Vinayrnani/vseedtaper/print/chassis.stl

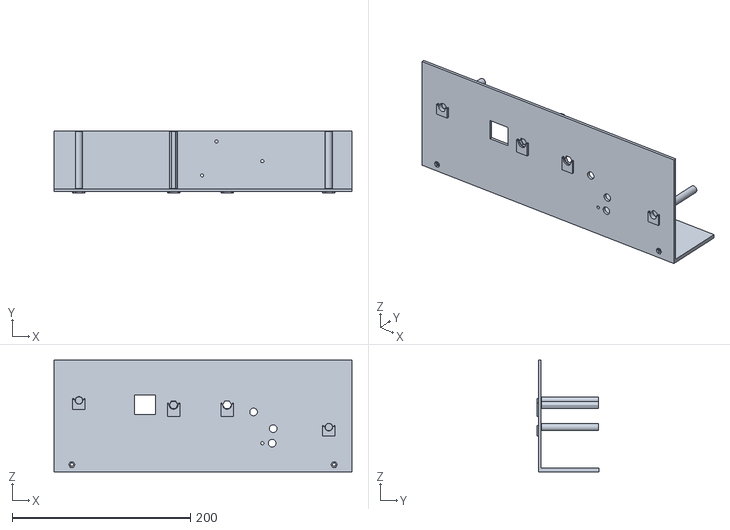
[picture p1: CAD file, 2026-09-26]
print/chassis.stl
334.0 x 70.0 x 125.0
