Vinayrnani/vseedtaper/print/plow.stl

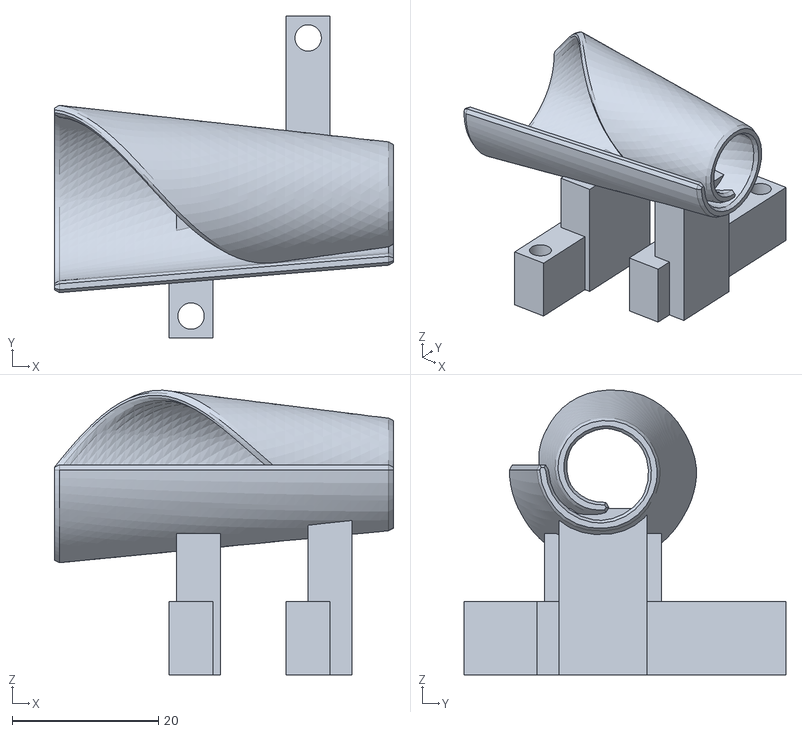
[picture p2: CAD file, 2026-09-26]
print/plow.stl
46.4 x 44.0 x 38.9
