Vinayrnani/vseedtaper/print/gear_A.stl

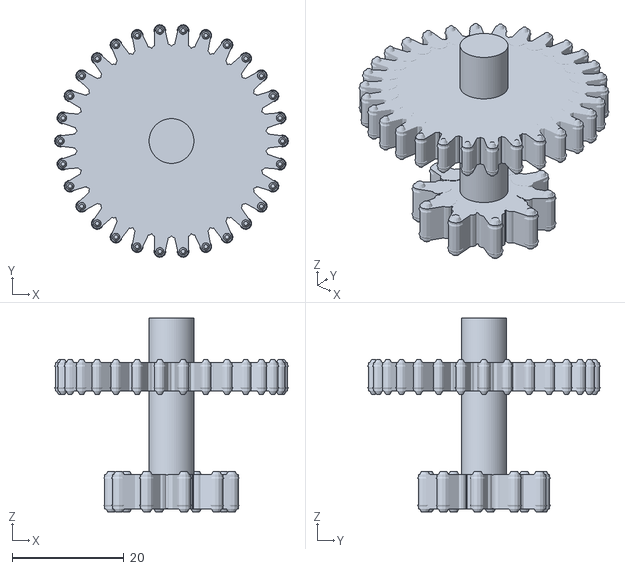
[picture p3: CAD file, 2026-09-26]
print/gear_A.stl
41.8 x 41.6 x 34.6
