Vinayrnani/vseedtaper/print/gear_I.stl

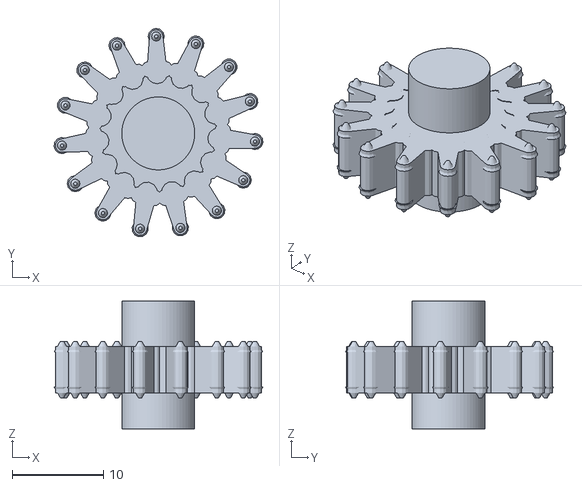
[picture p4: CAD file, 2026-09-26]
print/gear_I.stl
22.9 x 22.8 x 14.0
