Vinayrnani/vseedtaper/print/twister.stl

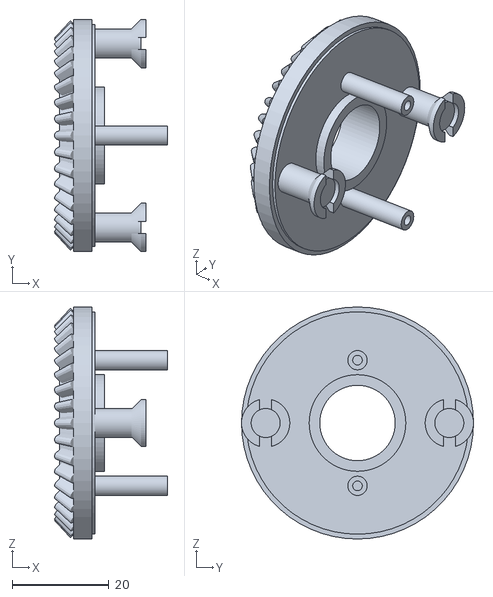
[picture p5: CAD file, 2026-09-26]
print/twister.stl
23.4 x 48.0 x 48.0
