Vinayrnani/vseedtaper/print/gear_B.stl

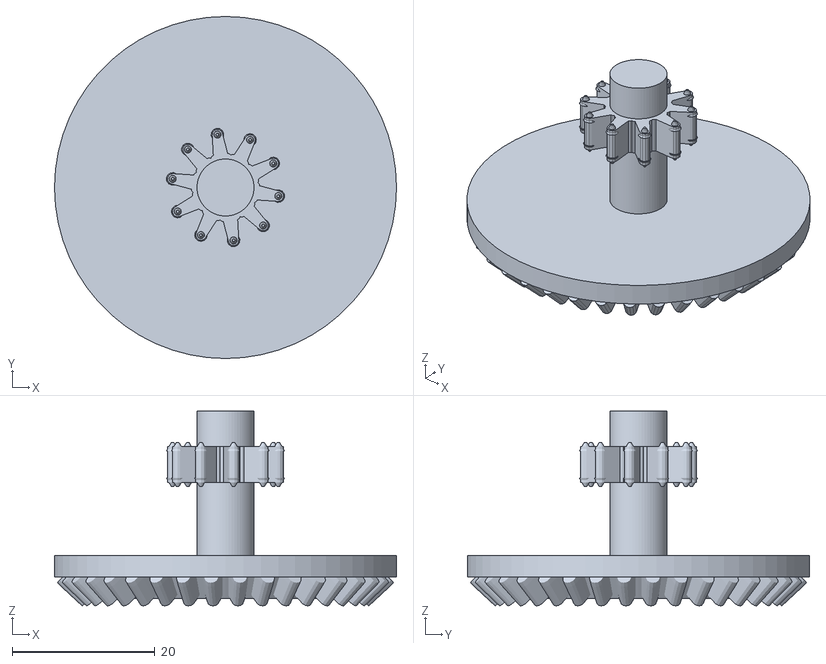
[picture p6: CAD file, 2026-09-26]
print/gear_B.stl
48.0 x 48.0 x 27.3
