Vinayrnani/vseedtaper/print/gearwall.stl

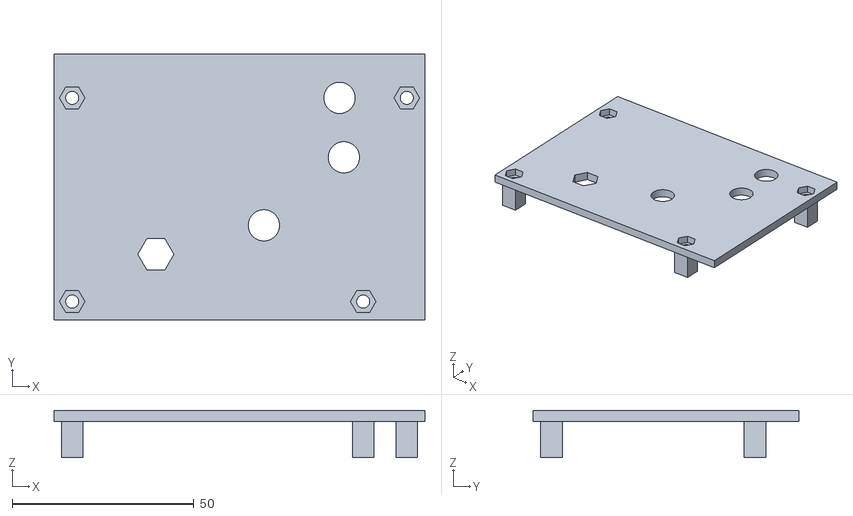
[picture p7: CAD file, 2026-09-26]
print/gearwall.stl
102.0 x 73.0 x 13.0
