Vinayrnani/vseedtaper/print/twister_axle.stl

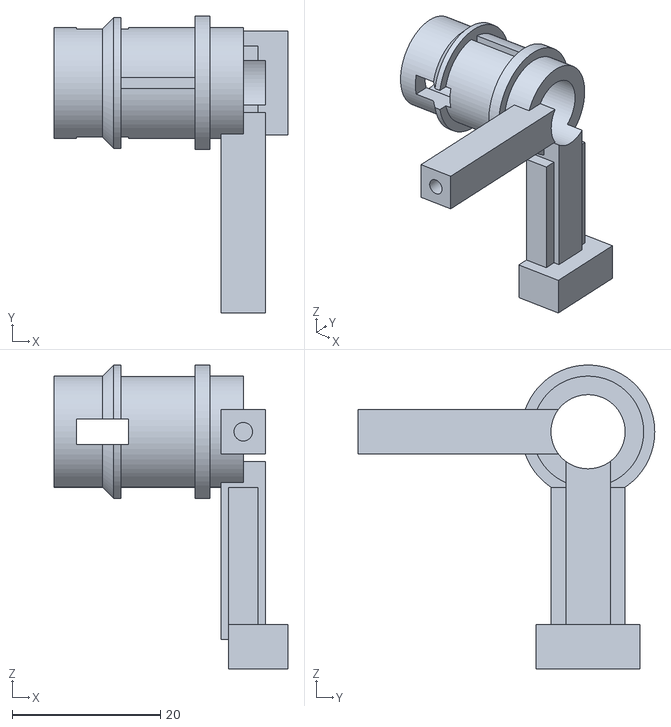
[picture p8: CAD file, 2026-09-26]
print/twister_axle.stl
31.5 x 40.0 x 41.0
