Vinayrnani/vseedtaper/print/u_former.stl

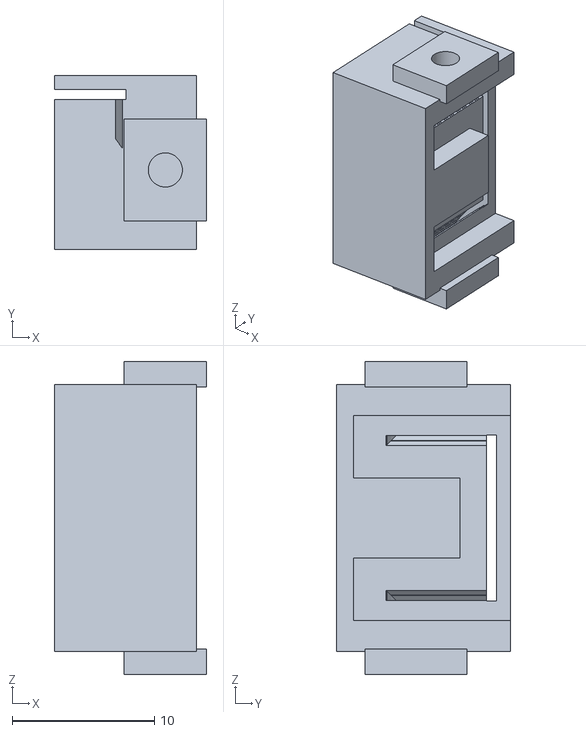
[picture p9: CAD file, 2026-09-26]
print/u_former.stl
10.7 x 12.2 x 22.0
