Vinayrnani/vseedtaper/print/tape.stl

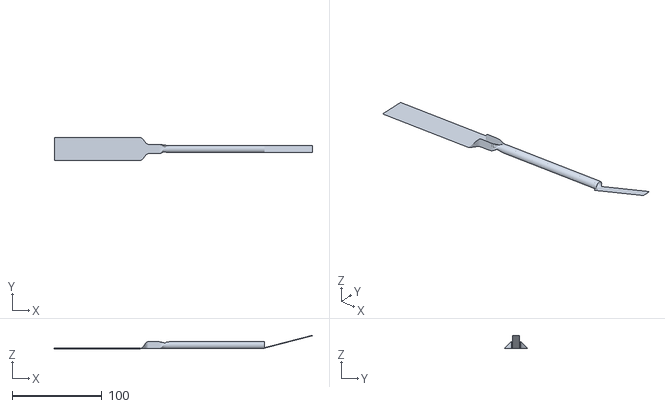
[picture p10: CAD file, 2026-09-26]
print/tape.stl
287.3 x 25.4 x 14.9
