Vinayrnani/vseedtaper/print/u_guide_bracket.stl

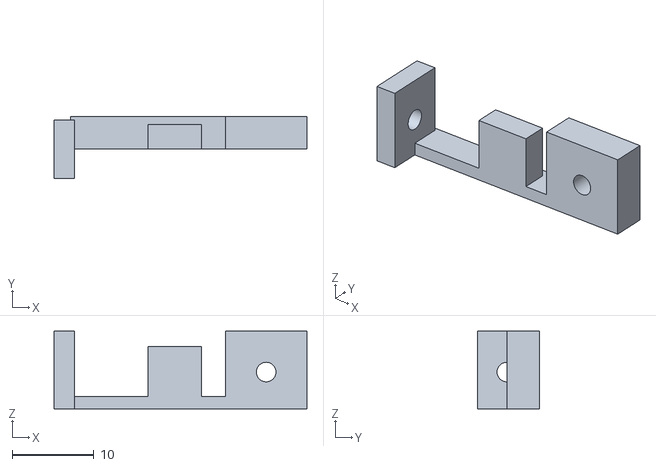
[picture p11: CAD file, 2026-09-26]
print/u_guide_bracket.stl
31.0 x 7.60 x 9.50
