Vinayrnani/vseedtaper/print/hopper.stl

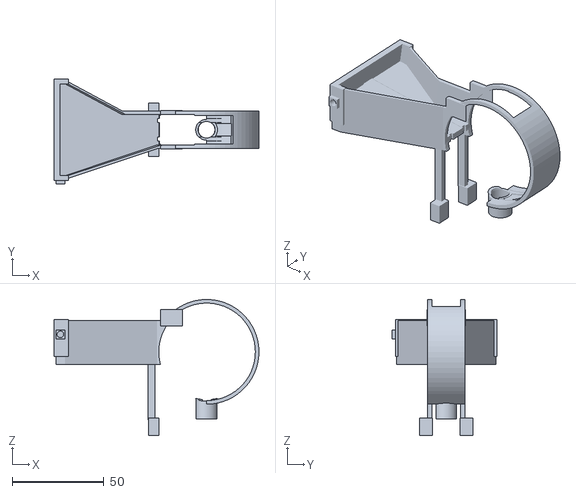
[picture p12: CAD file, 2026-09-26]
print/hopper.stl
111.5 x 57.1 x 74.0
