Vinayrnani/vseedtaper/print/south_wall.stl

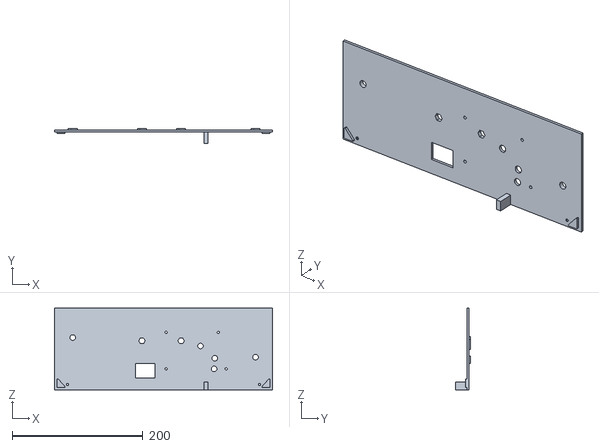
[picture p13: CAD file, 2026-09-26]
print/south_wall.stl
334.0 x 23.0 x 125.0
