Vinayrnani/vseedtaper/print/u_guide.stl

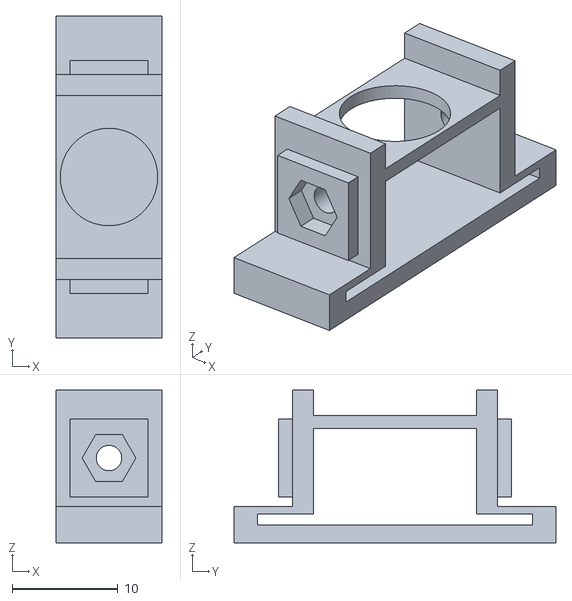
[picture p14: CAD file, 2026-09-26]
print/u_guide.stl
10.0 x 30.4 x 14.4
