Vinayrnani/vseedtaper/print/takeup.stl

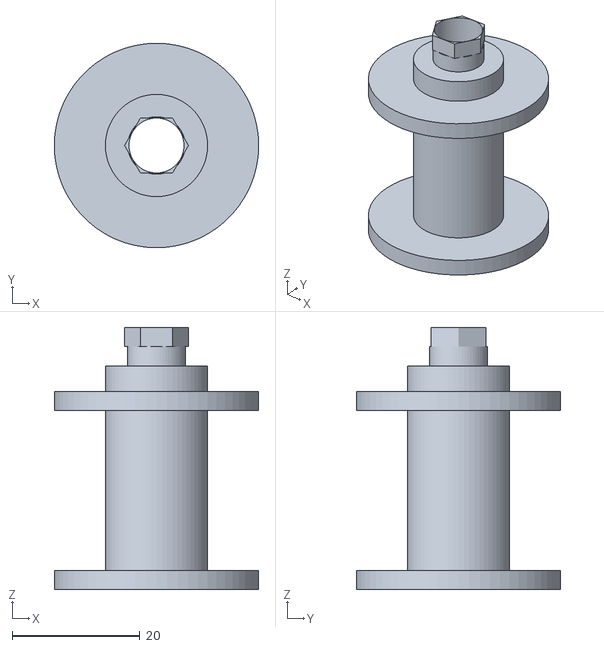
[picture p15: CAD file, 2026-09-23]
print/takeup.stl
32.0 x 32.0 x 41.0
