Vinayrnani/vseedtaper/print/crank.stl

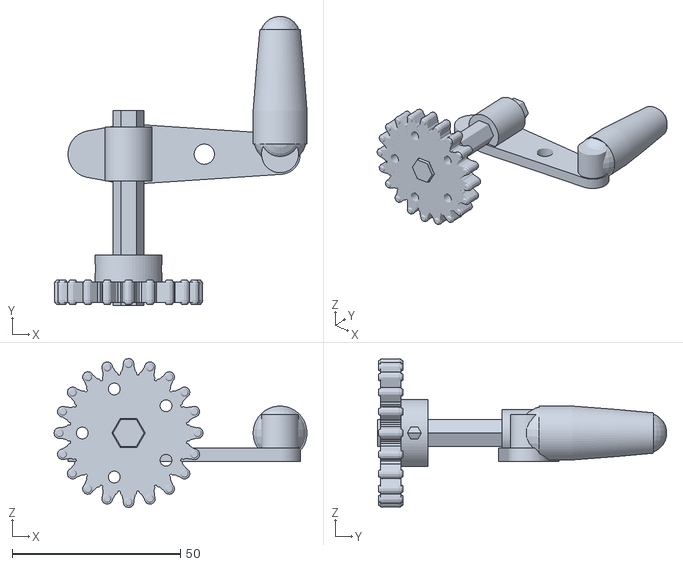
[picture p16: CAD file, 2026-09-23]
print/crank.stl
75.1 x 85.9 x 44.3
