Vinayrnani/vseedtaper/print/rollers.stl

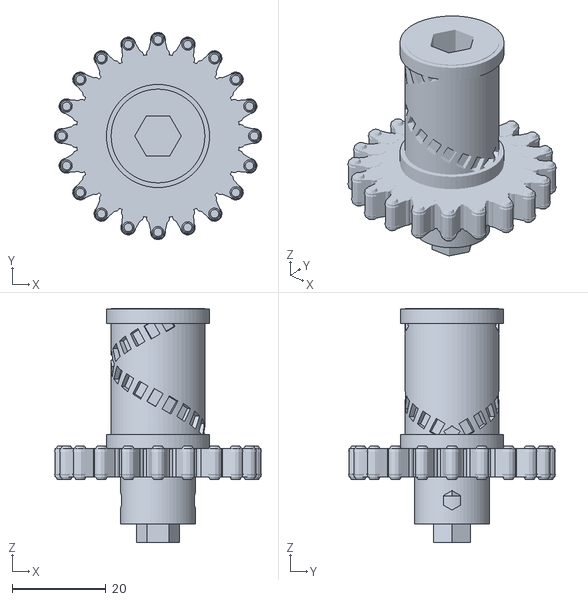
[picture p17: CAD file, 2026-09-22]
print/rollers.stl
44.3 x 44.3 x 50.0
