Vinayrnani/vseedtaper/print/cartridge.stl

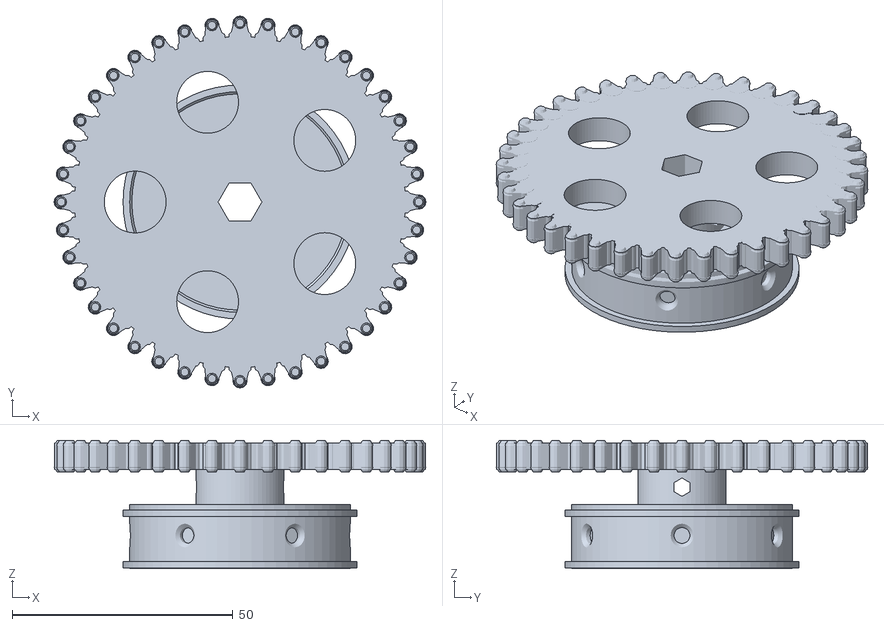
[picture p18: CAD file, 2026-09-22]
print/cartridge.stl
84.3 x 84.3 x 29.0
