Vinayrnani/vseedtaper/print/rollers_upper.stl

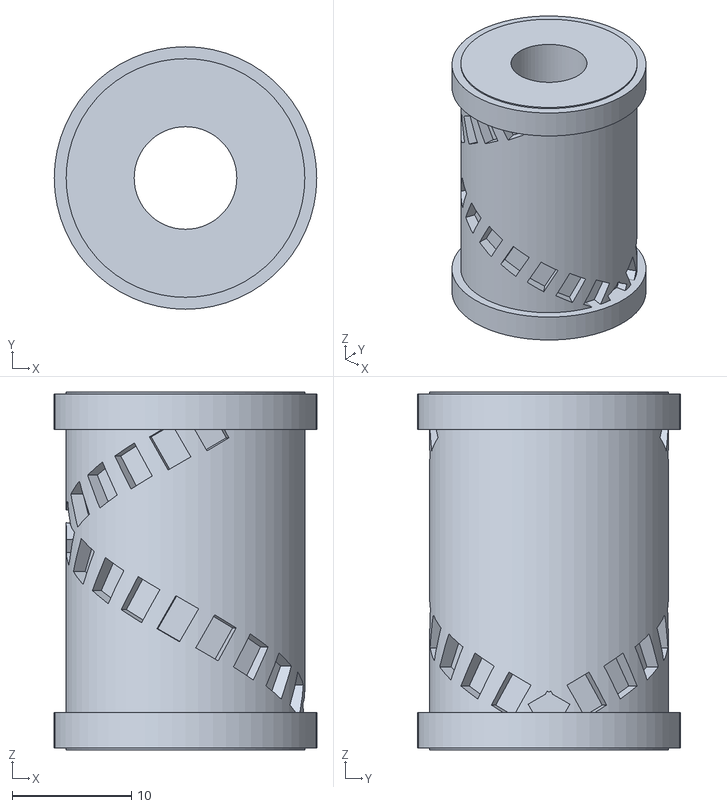
[picture p19: CAD file, 2026-09-22]
print/rollers_upper.stl
22.0 x 22.0 x 30.0
