Vinayrnani/vseedtaper/print/shroud.stl

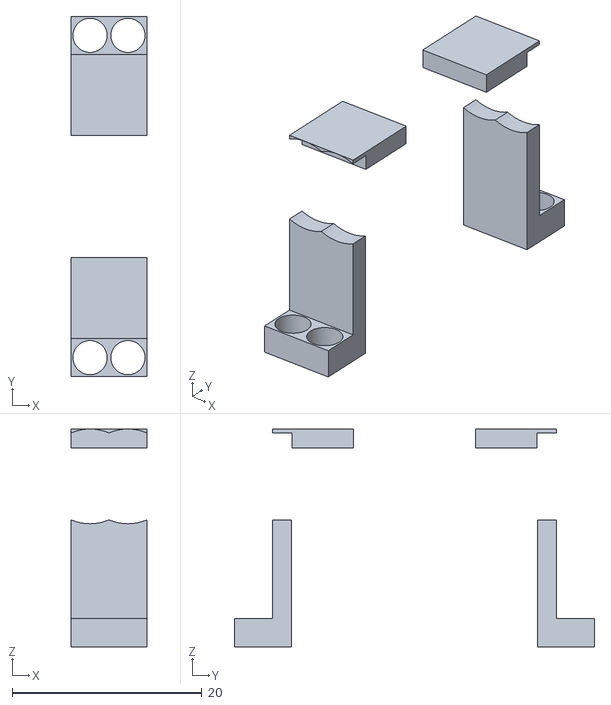
[picture p20: CAD file, 2026-09-22]
print/shroud.stl
8.00 x 38.0 x 23.0
