Vinayrnani/vseedtaper/scad/params.scad

/*
    Modular Hand-Cranked Seed Tape Machine - v2 Authoritative Spec
    ===========================================================
    v81: crank at x=160 (20T FRONT-plane gear meshes drum 40T, 2:1),
         28mm hex shaft at front, spur_gear in crank,
         rollers removed (upper deleted, lower replaced by crank axle).
    Parametric OpenSCAD 2021.01 - zero-error, manifold, flat-base parts.
    Allowed: diff/union/hull/cube/cylinder/sphere/rotate_extrude + transforms/for/if/echo/assert.
    NO minkowski/intersection/polygon/linear_extrude of text.
*/

// ============================================================
// Global variables (v2 spec)
// ============================================================
tolerance     = 0.3;
paper_width   = 25.4;
seed_dia      = 3.0;
seed_depth    = 2.0;
seed_spacing  = 152.4;   // v14 MVP fixed: 6 inch (152.4mm), driven by pull roller + gear ratio, 6 cavities
drum_radius   = 25;
drum_dia      = 2 * drum_radius;   // 50
drum_width    = 15;
$fn            = 60;

// ============================================================
// Kinematics / derived parameters (v2)
// ============================================================
gear_module   = 2;
roller_teeth  = 20;
drum_teeth    = 40;
center_distance = (roller_teeth + drum_teeth) * gear_module / 2; // 60
gear_thick    = 6;           // shared spur-gear face thickness (drum/crank)

// Gear tooth proportions (20 PA trapezoidal)
addendum   = 1.0 * gear_module;   // 2.0
dedendum   = 1.25 * gear_module;  // 2.5
tooth_arc_frac = 0.47;            // ~47% tooth thickness at pitch circle
// Root fillet (gears.scad, root corners of every tooth): a SINGLE cylinder of
// radius root_fillet_r whose centre sits root_fillet_offset OUTSIDE the root
// circle, so the fillet reaches root_r + root_fillet_offset + root_fillet_r.
// It lives HERE, not in gears.scad, because params.scad is included first: the
// clearance bound below reads these two numbers, and gears.scad reads the same
// two, so the bound cannot drift from the geometry when the fillet changes.
root_fillet_offset = 0.2;   // cylinder centre, outside the root circle
root_fillet_r     = 0.9;   // cylinder radius
v140_root_fillet_outer = root_fillet_offset + root_fillet_r; // 1.1

// Derived gear dimensions
roller_pitch_dia = gear_module * roller_teeth;   // 40
drum_pitch_dia   = gear_module * drum_teeth;     // 80
roller_outer_dia = roller_pitch_dia + 2*addendum; // 44
roller_root_dia  = roller_pitch_dia - 2*dedendum; // 35
drum_outer_dia   = drum_pitch_dia + 2*addendum;   // 84
drum_root_dia    = drum_pitch_dia - 2*dedendum;   // 75
roller_outer_r = roller_outer_dia/2;
roller_root_r  = roller_root_dia/2;
drum_outer_r   = drum_outer_dia/2;
drum_root_r    = drum_root_dia/2;

// Roller body diameter (spec: roller_dia=20)
roller_dia = 20;
roller_body_r = roller_dia/2;

// Gear mesh phase (v21: half-pitch of the 20T roller pinion (360/20/2 = 9°)).
// v140: RETIRED AS A VARIABLE - nothing in the CAD references it any more, so
// the old claim ("applied to the roller shaft rotation in animated_assembly")
// was false. It is kept as the one-line record of WHY the drum and crank
// meshes are phase-shifted at all, and the LIVE phases are:
//   drum<->crank : drum_angle's baked +4.5 deg (seed_tape_machine_v2.scad),
//                  the 40T drum half-pitch, tooth-into-gap;
//   crank<->A10  : crank_mesh_phase (baked into the printed crank gear, 0) plus
//                  the A-side total, which is split in two with opposing signs
//                  - v140_A_tooth_phase (A10 teeth only) and v97_A_phase
//                  (whole A cluster) - all below.
// Do not wire anything back to this name: a rigid phase bake is only
// admissible modulo the gear's own tooth pitch, and that is the whole reason
// the two crank phases below are not simply 9 deg.
gear_mesh_phase = 360/roller_teeth/2;   // 9 (documentation only)

// Circumference for tooth angular spacing
roller_circ_pitch = PI * gear_module;
drum_circ_pitch   = PI * gear_module;
tooth_arc_roller = tooth_arc_frac * roller_circ_pitch;
tooth_arc_drum   = tooth_arc_frac * drum_circ_pitch;

// Kinematics (v14 MVP: 6 cavities fixed, spacing 6 inch = 152.4 fixed;
// tape driven by pull roller via 40:20 mesh, drum geared slower vs roller)
tape_per_crank_rev = PI * roller_dia;         // ~62.83 (roller 1 rev)
drum_rot_per_crank = 0.5;
tape_per_drum_rev  = PI * drum_dia;           // ~157.08 (drum circumference, reference only)
tape_per_drum_rev_roller = PI * roller_dia * (drum_teeth / roller_teeth); // 125.66 actual tape/drum rev via pull roller
num_divots         = 6;                       // v14 MVP fixed: 6 cavities (wheels interchangeable by hand 1-6mm, count stays 6)
achieved_spacing   = tape_per_drum_rev_roller / num_divots; // ~20.94 with stock 20/40 gears; target 152.4 via future swap-gears (see GEAR_RATIO.md)
target_spacing     = 152.4;                   // v14 MVP: fixed 6 inch spacing

// ============================================================
// Axle layout (X,Z in OpenSCAD coords: X=tape travel, Z=up)
// v79 R->L order: crank (160, front) > six_turner (126..159) >
//   drum (100) > spool (-6, far west).
// Gear mesh: crank(160) 20T -> drum(100) 40T, dist=60=center_distance,
//   crank rotates 2:1 vs drum (crank_angle = 2*drum_angle).
//   Drum gear on FRONT plane (y≈47.95) for crank mesh.
// Plow stays EAST of drum (126->159, v1 precedent); tape scroll unchanged.
// v79: rollers REMOVED; crank carries the 20T pinion at x=160, front wall.
// ============================================================
drum_axle_x  = 100;
drum_axle_z  = 75;   // v87 +15 lift: ≥ drum_radius + base_thick + clearance = 29.3 ✓ (was 60)
assert(drum_axle_z == 75, "drum_axle_z must be 75 (+15 lift) — feeds hopper assembly +15");
crank_axle_x = 160;  // Step 13 fresh station: crank at the r60 mesh circle east of drum
crank_axle_z = 75;  // Step 13 fresh station: crank level with drum
assert(abs(sqrt(pow(crank_axle_x - drum_axle_x,2)+pow(crank_axle_z - drum_axle_z,2)) - center_distance) < 0.05,
       str("v95: crank must sit exactly on the r60 mesh circle about the drum, got ",
           sqrt(pow(crank_axle_x-drum_axle_x,2)+pow(crank_axle_z-drum_axle_z,2))));
// v97 composite take-off (user: revert gears, keep ONE composite 10->30 on
// the crank-gear wall): crank20(m2) -> A10(m2) [-2x, Y] +
// fused A30(m1.25) takeoff companion at the fresh Step 13 station.
A_ang = -15.5;  // Step 13 fresh station: A down-east of crank
v97_A_cd = (roller_teeth + 10) * gear_module / 2 + 0.75; // 30.75: crank20 -> A10 m2
v97_Ax = 189.702219;  // Step 13 fresh station
v97_Az = 67.041314;  // Step 13 fresh station
v97_A_y0 = 49.5; v97_A_y1 = 83;      // shaft r4 (stub cut; crosses outboard wall, tip ~2 proud)
v97_A10_y0 = 49; v97_A10_y1 = 55; // A10 m2 6 wide (Step 8: matches crank gear face 49-55)
v97_A30_y0 = 70; v97_A30_y1 = 75;     // A30 m1.25 30T OUTSIDE the wall (Step 2; B10 follows in Step 3)
v97_A30_outer_r = 20.75;              // A30 tip circle (m1.25 addendum); v140 hub-guard datum
A_rev = -2; // composite spins -2x crank (external mesh flips)
// v115 rim mitre (user: twister rim OD, same teeth both sides, 45°/45°):
// 36T m1.25 both (pitch r22.5, outer r23.75 ≈ disc OD46). Shared apex FIRST.
tw_bevel_outer_r = 23.75;  // the mitre bevel ring's tip circle (m1.25 addendum on r22.5).
                           // v140: named because it is the radius of the B-side
                           // teeth ENVELOPE, a cylinder about the B axis - the
                           // plow's floor-screw stations are stated against it
                           // (v141: they cleared it in x, not on a strap bridge).
tw_apex_x = 155; tw_apex_z = 32;   // source apex before the rigid twister frame
twister_frame_cx = 182.75; twister_frame_cy = 34; twister_frame_cz = 32;  // explicit 180Y frame center
twister_reflect_x = 2 * twister_frame_cx;  // rotor reflection datum: x' = 365.5 - x
twister_axle_x_shift = 6;  // axle-only east correction; rotor datum remains unchanged
twister_axle_reflect_x = twister_reflect_x + twister_axle_x_shift;  // final axle reflection datum: x' = 371.5 - x
twister_support_rib_x0 = 195; twister_support_rib_x1 = 201;  // axle support follows +6mm axle shift
twister_support_m3_x = [196.5, 199.5];  // axle support M3 stations follow +6mm axle shift
// Step-3a source-frame fused Γ support: final world X = 371.5 - source X.
twister_support_x0 = 169; twister_support_x1 = 175;
twister_support_wall_y0 = 3; twister_support_wall_y1 = 34;
twister_support_wall_z0 = 29; twister_support_wall_z1 = 35;
twister_support_floor_y0 = 31; twister_support_floor_y1 = 37;
twister_support_floor_z0 = 4; twister_support_floor_z1 = 32;
twister_support_wall_pilot_d = 2.5; twister_support_floor_pilot_d = 2.5;
twister_support_wall_pilot_y0 = 3; twister_support_wall_pilot_y1 = 13;
twister_support_floor_pilot_z0 = 4; twister_support_floor_pilot_z1 = 10;
twister_support_anchor_source_x = [172, 172];  // wall + floor local M3 anchors
twister_support_anchor_count = len(twister_support_anchor_source_x);
twister_support_wall_anchor_z = 32; twister_support_floor_anchor_y = 34;
twister_support_final_x0 = twister_axle_reflect_x - twister_support_x1;
twister_support_final_x1 = twister_axle_reflect_x - twister_support_x0;
twister_support_wall_anchor_final_x = twister_axle_reflect_x - twister_support_anchor_source_x[0];
twister_support_floor_anchor_final_x = twister_axle_reflect_x - twister_support_anchor_source_x[1];
twister_support_legacy_m3_z = 7;  // retired Step-13 interface, intentionally unused
tw_axle_foot_x0 = 166;  // west edge of the fused printable axle foot
tw_axle_support_x1_reflected = twister_axle_reflect_x - tw_axle_foot_x0;
tw_apex_x_frame = twister_reflect_x - tw_apex_x;  // 210.5 final twister apex
tw_bev_n = 36;                     // same count both sides (true mitre 36/36, 45°/45°)
tw_bev_mod = 1.25;                 // module (rim size)
tw_bev_face = 4;                   // face along generator (toe r19.67 solid over the bore)
tw_bev_thin = 0.9;                 // twister tangential thin (backlash)
v113_B_thin = 0.8;                 // B tangential thin (backlash; v95 pinion-thinning precedent)
tw_bev_phase = 0; v113_B_phase = 5; // tooth-into-gap (half-pitch of 36T): B teeth mesh twister gullets
v113_B_heel_y = 56.5;              // B heel pitch circle (apex 34 + r22.5 @45°)
tw_bev_heel_x = 177.5;             // source twister heel pitch circle
 tw_bev_heel_x_frame = 2 * twister_frame_cx - tw_bev_heel_x; // 188 final frame heel
tw_relief_x0 = 177.7; tw_relief_x1 = 179.5; // back-cone relief annulus (trims heel backs like real bevels, catches B heel corner)
tw_relief_r0 = 20; tw_relief_r1 = 23;
// B station: Y-axis THROUGH the apex (mate-driven, off the A circle).
// B10 stays in the A30 band (idle; next-step intermediate meshes it).
v98_Bx = tw_apex_x_frame; v98_Bz = tw_apex_z;  // Step 13 B/apex station (210.5, 32)
v98_B_y0 = 54; v98_B_y1 = 80;      // shaft r4 (v117: inboard stub cut into the bevel band; tip 2 deep in the gearwall slip bore)
v98_B10_y0 = 70; v98_B10_y1 = 75;  // B10 m1.25 kept (idle for the next step)
// Step 5 outboard support wall (user: extra wall outside carrying the A/B
// shaft tips): plate y78-81 over both axes + four canonical 6x6 supports
// face-touching the removable south wall at y68 and fusing into the plate.
bolt_dia = 3;
bolt_head_across = 5.5;
nut_trap_depth = 2.5;
v105_wall_x0 = 132; v105_wall_x1 = 234; // extended plate X span
v105_wall_z0 = 20;  v105_wall_z1 = 93;  // plate Z span, extended 6mm downward
v105_wall_y0 = 78;  v105_wall_y1 = 81;  // plate Y span
v105_pillar_xz = [[137, 32], [137, 88], [217, 88], [229, 32]];
v105_pillar_y0 = 68; v105_pillar_y1 = 80; // face-touch south wall, fuse into plate
v105_pillar_s = 6; v105_pillar_half = v105_pillar_s/2;
v105_pillar_corner_r = v105_pillar_half * sqrt(2);
v105_pillar_screw_d = bolt_dia + 2*tolerance;
v105_pillar_nut_r = (bolt_head_across + 2*tolerance) / sqrt(3);
v105_nut_trap_floor = 78.45; // v105_wall_y1 - (nut_trap_depth + epsilon)

// Live B bevel support: standard 36T teeth remain unchanged and hang from
// the full-radius Step 4 backing web; the web is behind the nominal heel
// plane and overlaps the root frustum without extending into the toe/mesh.
v98_Bbev_y0 = 52.5; v98_Bbev_y1 = 57.5; // v115 Bbev36 teeth envelope (toe 53.7, heel 56.5 + tip drift; apex-down mitre)
// Step 4 live B backing web: full radius behind the nominal heel plane,
// with a 0.3mm overlap into the existing root frustum.
B_back_web_r = 24;
B_back_web_t = 3;
B_back_web_z0 = 19.3;
B_back_web_z1 = 22.3;
B_root_frustum_z0 = 22;
B_root_frustum_z1 = 25.3;
B_root_frustum_r0 = 21;
B_root_frustum_r1 = 18.2;
B_back_web_y0 = v98_B_y0 + 25 - B_back_web_z1; // assembly Y=56.7
B_back_web_y1 = v98_B_y0 + 25 - B_back_web_z0; // assembly Y=59.7
// Legacy v103/v106 helper parameters remain only for the unused dt_bevel_blank helper.
v106_bev_web_top = 63.5; // legacy helper datum
v106_bev_lift = v106_bev_web_top + 6 - v98_B_y0; // legacy helper datum
v103_bev_flange_r = 10;  // legacy helper only
v103_bev_flange_t = 2;   // legacy helper only
B_rev = -6; // idler-driven train: A -2x, two flips, B -6x crank
twister_rev = -6; // 1:1 mitre preserves B's -6x direction, intentionally reversed twister
// v116 Step-2 idler (user: connect A and B with an intermediate gear):
// 15T m1.25 spur bridging A30 (r18.75) and B10 (r6.25) in the shared band
// 70-75. Two-circle solve: |I-A| = 18.75+9.375+0.75 = 28.875,
// |I-B| = 6.25+9.375+0.75 = 16.375 -> west solution (east hits twister).
// Idler is idler: B = -A.(30/10) = -6x regardless of idler size.
v115_Ix = 211.695428; v115_Iz = 48.331307; // Step 13 fresh idler station
v115_I_y0 = 66; v115_I_y1 = 80;    // shaft r4 (front-wall bore + gearwall bore, tip 2 deep)
v115_I15_y0 = 70; v115_I15_y1 = 75; // idler 15T band (meshes A30 + B10 bands)
v115_I_phase = 12;                 // half-pitch tooth-into-gap (thin teeth + visual verify)
// ---- crank20 <-> A10 static mesh PHASE (v140) --------------------------------
// The line of centres crank->A is EXACTLY -15 deg in global coords: from the
// crank at (160, 75) to the A10 at (189.702219, 67.041314),
// atan2(67.041314-75, 189.702219-160) = -15.0000007 deg.
// The crank gear is DRAWN under rotate([-90,0,0]) (stations.scad), and that
// rotation maps (x,y,z) -> (x,z,-y), so a crank-LOCAL angle is the NEGATIVE of
// the global X->Z angle. spur_gear() draws teeth on multiples of 360/teeth, so
// a phase is only defined modulo the tooth pitch, and the A10's is 36 deg.
// dt_cluster_A is under rotate([90,0,0]), so an A-LOCAL angle IS the global
// angle, and a Y rotation of psi maps a global angle phi to phi - psi, while a
// spur_gear tooth_phase of theta adds +theta: the A10's tooth set therefore
// sits at 36j + v140_A_tooth_phase - v97_A_phase globally, and the
// A->crank line is at 165 deg.
// Centre distance stays 30.75: the 0.75 over theoretical 30.00 is deliberate
// operating slack (1.25 radial at the tips), so this is a PHASE fix only.
//
// WHY crank_mesh_phase IS 0 AND THE A-SIDE TOTAL IS -9 (v140, measured not
// assumed):
// The crank gear meshes TWO gears in the same y band 49..55 - the drum 40T and
// the A10 - and the two requirements are 15 deg apart modulo the crank's own
// 18 deg tooth pitch, so NO single rigid phase can satisfy both. Measured with
// a trimesh intersection sweep of the two real meshes (crank angle 0):
//
//   crank_mesh_phase   crank<->drum40    crank<->A10 at v97_A_phase -3
//        0  (HEAD)         4.2018              11.9819
//       -3                 42.2840              0.0000
//       +3                 42.2840             -
//       +6                 90.2131             -
//       +9                118.5083             -
//   (-18 and +18 reproduce 0 exactly: the drum column is 18 deg periodic,
//    which is the proof that a rigid bake only exists modulo the tooth pitch.)
//   (The A10 column is the single-dial scan with v140_A_tooth_phase 0, i.e. the
//    whole A phase on the cluster alone.)
//
// So the drum 40T mesh - the approved one, and the one the crank exists to
// drive - admits exactly one rigid phase, 0, and 0 is HEAD. The crank<->A10
// mesh is therefore fixed on the A side instead, where the phase costs no
// printed geometry at all: it is an ASSEMBLY-time rotation.
//
// v140: the A-side phase is carried by TWO constants with OPPOSING signs, and
// the split is not cosmetic:
//   v140_A_tooth_phase  +6  deg  turns the A10's TEETH ONLY (spur_gear's
//                               tooth_phase) - bores/hub stay at phase 0;
//   v97_A_phase         -3  deg  rotates the whole A cluster about Y at
//                               assembly, which is a MINUS on the A10's global
//                               tooth angle (a Y rotation of psi maps a global
//                               angle phi to phi - psi).
// So the effective A10 phase in the assembly convention (params comment above:
// teeth at 36j + v140_A_tooth_phase - v97_A_phase) is
//   v97_A_phase - v140_A_tooth_phase = -3 - 6 = -9,
// i.e. byte-for-byte the HEAD single-dial -9. Measured: crank<->A10 overlap
// 0.0000 mm3 at crank 0/4.5/9/13.5/18/22.5/27, crank<->drum 4.2016 mm3
// (unchanged), at every one of those angles.
//
// WHY IT IS SPLIT INSTEAD OF ONE DIAL: v97_A_phase rotates the WHOLE cluster,
// and the cluster also carries the A30 takeoff disc and its 15T idler. The -9
// one-dial value moves the A30<->idler mesh too, and that mesh already
// interferes; -9 makes it worse (16.3 -> 29.4 mm3 at crank 0). Only the A10
// needs the mesh phase, so only the A10 gets it, and the cluster rotation is
// cut to -3 - the smallest assembly phase that leaves the crank<->A10 total at
// -9. -3 is the most cluster rotation is allowed to keep, not the target: the
// target is the -9 TOTAL.
v140_A_tooth_phase = 6; // deg: A10 TEETH only (drive_train.scad:26); +ve = CCW
v97_A_phase = -3;   // deg: whole A cluster about Y at assembly (mirrored in the viewer as
                     // A_GEAR_PHASE). Total A10 phase = v97_A_phase - v140_A_tooth_phase.
crank_mesh_phase = 0;    // deg: the drum 40T mesh admits no other rigid phase
crank_tooth_pitch = 360/roller_teeth;   // 18 deg: the modulus a crank phase lives in
crank_A_mesh_target = -9;  // deg: the coupled crank/A TOTAL phase, measured (see 5b)
// v140: the A10 is thinned (tooth_scale) so its flanks clear the crank's root
// fillets. drive_train.scad:22 reads this constant - do not re-inline 0.8 there.
v140_A_thin = 0.8;
v140_A_teeth = 10;         // A10 tooth count (drive_train.scad:22); fixes the 36 deg gap pitch
// ---- v141 starting-angle alignment of the m1.25 TAIL meshes ----------------
// MEASURED, not assumed. Method: a throwaway /tmp probe exported the boolean
// intersection() of each pair at the TRUE assembly transforms, unioned with a
// 1 mm3 marker cube parked at (-900, 0, -900) so a genuine zero still yields a
// readable STL; trimesh read (sum of body volumes - 1.0). Every dial was swept
// in 0.5 deg steps over at least one full tooth pitch.
//
// THE COMPLETE MESH TABLE of the live assembly (animated_assembly):
//   pair            teeth/mod    centres (x,z)          LoC      CD       free side
//   crank20-drum40  20/40 m2     (160,75)-(100,75)       0 deg    60.00    NONE (both fixed)
//                                (LoC is drum->crank; crank->drum is 180)
//   crank20-A10     20/10 m2     (160,75)-(189.70,67.04) -15 deg  30.75    A10 (total -9)
//   A30-idler15     30/15 m1.25  (189.70,67.04)-(211.70,48.33) -40.4  28.875  A30 + idler
//   idler15-B10     15/10 m1.25  (211.70,48.33)-(210.50,32)  -94.2  16.375   idler + B10
//   Bbev36-twister36 mitre 36/36 m1.25, 45/45, apex (210.5, 32)         B + twister bevel
// The drum meshes with NOTHING except the crank (both rows above are its only
// partner), and neither the drum nor the crank is re-phased here: the drum
// angle is baked in seed_tape_machine_v2.scad (+4.5) and crank_mesh_phase
// must stay 0 (assert 5 below). The mitre pair is a bevel mesh carrying its
// own phase_deg in bev_teeth (tw_bev_phase 0 / v113_B_phase 5, half-pitch of
// 36T); it is not a spur mesh and v141 does not touch it.
//
// RESULT (mm3 of overlap: crank angle 0 / worst over the 6 deg crank period in
// which each mesh's configuration repeats, sampled at 0.5 deg of crank - the
// SAME 13 samples for every row, HEAD and v141 alike):
//   pair            HEAD (ca0 / worst)   v141 (ca0 / worst)
//   crank20-drum40  4.2016 / 4.4478      4.2016 / 4.4478   (untouched, forbidden)
//   crank20-A10     0.0000 / 0.0000      0.0000 / 0.0000   (untouched, preserved)
//   A30-idler15     16.3321 / 18.1454    0.1098 / 0.9064   (worst of the two dials)
//   idler15-B10     32.2040 / 32.3811    0.0158 / 0.0433
// A static phase cannot hold a fixed overlap through the revolution, because
// these are trapezoidal teeth, not conjugate profiles: as a pair rolls, the
// contact keeps conjugacy but the interference breathes. The "worst" column is
// therefore the number that decides, and it is what every dial was minimised
// on. (The coarser 7-angle HEAD spot-check reads 4.8528 / 18.1613 / 32.8412 -
// same picture, coarser sampling.)
//
// The idler is in TWO meshes and the two required phases are 6.7 deg apart
// (A30-idler wants 19.2, idler-B10 wants 12.5), so no single idler value is
// clean for both. The train has three free dials for two meshes, so the third
// (the B10) absorbs the difference: v115_I_phase stays 12 and the A30-idler
// correction rides on the idler TEETH, and the B10 carries its own. The worst
// mesh is what was minimised; the residuals are stated, not hidden.
//
// WHY tooth_phase AND NOT A CLUSTER ROTATION: spur_gear(tooth_phase=) turns
// the teeth only, so every bore, hub and collar stays at phase 0 and the part
// still drops onto a shaft drawn at phase 0. v115_I_phase (12) is kept as the
// idler's assembly rotation and the new v141 dial is the idler's teeth; the
// idler gear is solid (no bore) so the two are interchangeable there, but the
// teeth-only form is the one that cannot move a bore.
v141_A30_tooth_phase = 0;    // deg: A30 TEETH only (dt_cluster_A). THE MEASURED
                             // OPTIMUM IS ALREADY HEAD. Swept 0..12 at 0.5 deg at the
                             // FINAL idler phase, worst over the 6 deg period:
                             // -0.3 -> 1.2416, -0.2 -> 1.0319, -0.1 -> 0.9304,
                             //  0.0 -> 0.9064 (the minimum, and the lowest mean
                             //  0.4383 too), 0.1 -> 0.9233, 0.2 -> 0.9839,
                             //  0.3 -> 1.1501. So the A30<->idler correction is
                             // carried ENTIRELY by the idler and the printed gear_A
                             // stays byte-identical to v140 (verified: identical STL
                             // volume AND identical bounds). The dial is wired anyway
                             // as the fail-loud record of that measurement.
v141_I15_tooth_phase = 4.8;  // deg: idler 15T TEETH only (dt_idler). SIGN NOTE: the
                             // sweep dial was the CLUSTER rotation (a Y rotation of
                             // psi maps a global angle phi to phi - psi), so the dial
                             // that measured best, 19.2, is a global tooth phase of
                             // -(12 + 19.2) = -31.2. The cluster already supplies -12,
                             // so the teeth carry -31.2 + 12 + 24 = 4.8 - identical
                             // gear (one 24 deg pitch), and 4.8 - 12 = -7.2 = -31.2 + 24.
                             // Swept 0..24 at 0.5 deg (worst over the 6 deg period,
                             // 0.75-deg crank sampling):
                             // 0 -> 18.1613, 12 (HEAD) -> 31.1313, 18.5 -> 1.2898,
                             // 19.0 -> 0.9262, 19.1 -> 0.9120, 19.2 -> 0.9064 (the
                             // minimum), 19.3 -> 0.9122, 19.5 -> 0.9674, 24 -> 18.1613
                             // (24 deg periodic: the proof that a rigid phase lives
                             // only modulo the tooth pitch). Plateau 19.0..19.3 spans
                             // 0.9064..0.9262, so the value is not knife-edge.
v141_B10_tooth_phase = 9.3;  // deg: B10 TEETH only (dt_cluster_B). Swept 0..36 at
                             // 0.5 deg with the idler at 19.2: 0 -> 15.9742 (ca0),
                             // 8.5 -> 0.4131 worst, 9.0 -> 0.1299, 9.2 -> 0.0635,
                             // 9.3 -> 0.0433 (the minimum), 9.5 -> 0.0719, 10.0 ->
                             // 0.3118, 10.5 -> ca0 0.000000 BUT worst 0.6749 (the clean
                             // window slides with the crank angle), 11.0 -> 1.1410,
                             // 36 -> 15.9742 (36 deg periodic).
// WHAT THE VIEWER MIRRORS: only the ASSEMBLY-time phases, because a
// tooth_phase is already inside the exported teeth (web/index.html carries the
// full bookkeeping). So pivotI.rotation.z gets v115_I_phase (12 deg) and NOT
// v141_I15_tooth_phase; the B10's 9.3 comes out of the gear_B regen, and the A10's
// 6 (v140) out of the gear_A regen. The idler's resulting GLOBAL tooth phase is
// v141_I_live below, which is what the measured mesh line is stated against.
v115_I_thin = 0.8;                 // idler thin (mesh forgiveness; v95 precedent)
I_rev = 4; // idler spins +4x crank (-A.30/15)
spool_axle_x  = -6;  // v22: 10->-6, clears roller back gear (box-level X gap 1.5)
spool_axle_z  = 80;  // v87 +15 lift: 120mm max roll OD, height 80mm above base (was 65)
assert(spool_axle_z == 80, "cone rod (spool_axle_z) must be 80 (+15 lift)");

// ============================================================
// Chassis
// ============================================================
chassis_x0    = -34; // Step 3: west edge X=-34
chassis_len   = 334; // Step 3: length 334 mm, east edge X=300 (+30 mm at east/take-up end)
chassis_width = 68;
lane_y = chassis_width / 2;  // lane center, was hardcoded 30
chassis_height = 125;  // v87 +15: > max(spool top=105, drum top=117) + 5 = 122 ✓ (was 110)
base_thick    = 4;
wall_thick    = 3;

// ============================================================
// Plow (downstream closer, v1 precedent: stays EAST of drum) +
// Fold zone (v31: forming station fully WEST of the drum face so the
// tall U walls never meet the wheel; shallow entry at the roller nip,
// full-U forming exit at x=70, then a straight full-U transit (same
// cross-section, no taper) runs EAST, UNDER
// the drum with air gap, INTO the drop-tube west side inlet at x=93,
// through the bore (seed drops into the moving pocket at x=100) and
// on to the plow mouth at 126 which closes/seals it downstream)
// ============================================================
plow_start    = drum_axle_x + drum_radius + 1; // 126 (east of drum, unchanged)
plow_len      = 33; // v79 FIXED: decoupled from old roller_axle_x.
                     // Plow stays east (v1 precedent).
plow_end      = plow_start + plow_len; // 159
// Step 6: the old U-bend at the roller nip is RETIRED. The flat 25.4 ribbon
// now runs on, and the U is folded exactly once by the new u_former part
// (former_x0..former_x1) far downstream, UNDER the dropper. fold_start,
// fold_end and fold_len are gone: the straight full-U transit is measured
// from the real, self-supporting end of the fold instead of a retired station.
// transit_start / transit_end / transit_len live in the Step 6 block below:
// they are measured from u_stable_end_x, and OpenSCAD evaluates assignments in
// file order, so that station must already exist when they are read.
// (S4) fold_width, tape_bend_radius, tape_fold_angle, tape_fold_wall,
// tape_shoulder_r/ang and tape_n_arc/tape_n_x described that RETIRED fold and
// had no readers left; they are gone with it. The U-former sizes itself from
// the u_* constants below.
track_depth   = 3;

// ============================================================
// Rollers
// ============================================================
roller_len    = 30;
axle_dia      = 8; // 8
hex_axle_flat = 8;
hex_axle_r    = hex_axle_flat / sqrt(3);
axle_clearance_dia = axle_dia + 2*tolerance; // 8.6
hex_clearance_r  = (hex_axle_flat + 2*tolerance) / sqrt(3);
// v45 DEAD AXLES (forensic fix: drum + reel + spool cones were held
// by NOTHING — bores + wall/block holes with no shaft modelled;
// parts spun on viewer pivots but the steel read as floating).
// Static bars in chassis(): slip-fit through bores/holes (tol gap
// all around, spinning parts stay free); the drum shaft fuses into
// the solid v47 drum bevel (no bore). Back ends stop INSIDE the back
// wall/block bores (y=1 in wall 0..3 — hidden, never exterior, never
// coplanar; v47: no exterior gears means nothing to bury into, so the
// wall itself hides them — zero exterior clutter).
drum_shaft_y0 = 1;    // hidden in the back wall/block bore (wall 0..3)
drum_shaft_y1 = 67;   // hidden in the front drum-block bore
takeup_shaft_y0 = 1;  // hidden in the back wall/block bore (wall 0..3)
takeup_shaft_y1 = 67; // hidden in the front take-up block bore
spool_shaft_y0 = 1;    // hidden in the back spool-block bore
spool_shaft_y1 = 67;   // hidden in the front spool-block bore
// Step 1 flat floor + Step 2 wall-local M3 interface. Both walls carry
// matching clearance holes/nut traps; no bosses or pilot holes occupy the floor.
wall_screw_x = [chassis_x0 + 20, chassis_x0 + chassis_len - 20];
wall_screw_z = 8;
wall_screw_clearance_d = bolt_dia + 2*tolerance;
wall_screw_nut_r = (bolt_head_across + 2*tolerance) / sqrt(3);
south_wall_bore_y = chassis_width - wall_thick/2;
// v143 BOTH plow screws are now fitted FROM ABOVE - there is no screw anywhere
// on this machine that has to be reached from underneath to drive. Each side is
// an L: a vertical pedestal plus a SHORT horizontal arm whose top face carries
// the screw head, with the shaft down through the arm and the chassis floor and
// a hex nut underneath.
//  A (north, world 132,18): the arm stops 12mm short of the fixed wall.
//  B (south, world 148,56): measured on the assembled machine, the only
//    sky-clear columns south of the scroll are y 47.4..48.3 - a 0.9mm slot
//    under the paper lane, which no driver shaft can enter - and y 55.7..64.8,
//    a 9.1mm band sitting 41mm below the crank/drum gear rim. B therefore sits
//    in the 9.1mm band, and the gear's shadow band (y 48.4..55.6) between the
//    pedestals and that band is what makes B's arm longer than A's.
plow_axis_local_y = 20;                          // scroll axis in plow-local y
plow_frame_y0 = lane_y - plow_axis_local_y;      // 14: world y of plow-local y0
plow_arm_w = 6;                // arm A width in x (the old strap width)
plow_arm_h = 10;               // arm A height z0..10; its TOP face carries the head
plow_arm_gap = 12;             // fixed-wall inner face -> arm A's outer end
plow_arm_fuse = 3;             // volumetric overlap of arm A into pedestal A
plow_arm_end_ligament = 1.2;   // material between arm A's hole and its end face
plow_arm_end_y = wall_thick + plow_arm_gap;     // 15
plow_screw_a_x = plow_start + 6;                // 132 = arm A's x midline
plow_screw_a_y = plow_arm_end_y + (bolt_dia + 2*tolerance)/2 + plow_arm_end_ligament;  // 18
plow_screw_a_len = 20;          // M3x20 = arm 10 + floor 4 + nut 2.5 + 3.5 spare
plow_arm2_w = 6;               // arm B width in x
plow_arm2_h = 10;              // arm B height z0..10
plow_arm2_gap = 6;             // south gear-wall inner face -> arm B's outer end
plow_arm2_fuse = 3;            // volumetric overlap of arm B into pedestal B
plow_arm2_end_ligament = 1.2;  // material between arm B's hole and its end face
plow_arm2_end_y = chassis_width - wall_thick - plow_arm2_gap;                    // 59
plow_screw_b_x = plow_end - 8 - plow_arm2_w/2; // 148: pedestal B's centre (151) less half the arm
plow_screw_b_y = plow_arm2_end_y - (bolt_dia + 2*tolerance)/2 - plow_arm2_end_ligament;  // 56
plow_screw_b_len = 20;         // M3x20, same stack as A
m3_head_h = 2.0;               // M3 cheese head DIN 1207: dk 5.5 (bolt_head_across) x k 2.0
plow_screw_x = [plow_screw_a_x, plow_screw_b_x];   // the two chassis stations
plow_screw_y = [plow_screw_a_y, plow_screw_b_y];
plow_foot_ligament = 1.0;      // min material around a floor screw
plow_foot_max_span = 46;       // max allowed Y footprint (both arms set it)

// Bearing block dimensions
bb_len = 14;
bb_wall = 4;
bb_height_roller = 13;
bb_height_drum   = 13;
bb_height_spool  = 10;

// ============================================================
// Hopper (v14 MVP: closed seed box at 9 o'clock, max volume to 10:30;
// horizontal top z=73)
// ============================================================
hopper_wall     = 2.5;
hopper_flange_thick = 3;
hopper_clearance = 0.3;
hopper_inner_r  = drum_radius + hopper_clearance; // 25.3
hopper_outer_r  = hopper_inner_r + seed_dia + 3;  // 30.8
hopper_axis_z   = 56;  // v87 +15 lift: frozen local axis (assembly Z = drum_axle_z - 56 = base_thick + 15; was drum_axle_z - base_thick which tracked and broke body frame)
wiper_slot      = 1.2;
groove_w        = 7;     // inner-face groove width, matches drum cavity track (fits 6mm cavities d6.6)
groove_d        = 0.7;   // v27 printable: 0.8 left only 1.175 wall (<1.2); 0.7 leaves ~1.275, still clears cavity protrusion 0.6
// Step12: drum flange register (female) grooves — hopper ONLY (shroud removed).
// Drum end flanges OD53 r26.5, 1.5 wide at local Y +/-5 (world 29/39).
// Recess EXPLICIT oversize (not tolerance-derived): r26.65 + w1.8.
flange_reg_r = 26.8; // recess radius (flange r26.5 + 0.3 print clearance)
flange_reg_w = 2.1;   // recess width (flange 1.5 + 0.6 oversize)
flange_reg_y = 5;     // groove centre offset local Y +/-5
assert(flange_reg_r - (drum_dia + 3)/2 >= 0.2 && flange_reg_r - (drum_dia + 3)/2 <= 0.4, str("Step12: flange register radial clearance must be in [0.2,0.4] (0.3 print): ", flange_reg_r - (drum_dia + 3)/2));
assert(flange_reg_w - 1.5 >= 0.2, str("Step12: flange register width oversize must be >=0.2: ", flange_reg_w - 1.5));

// ============================================================
// Step 5: U guide / hopper-mounted M2 interface
// ============================================================
// Shared M2 hardware is an intentional exception to the general tol=0.3
// machine clearance.  Keep the values named so every local module can fail
// loudly if a later edit changes a screw seat or span.
m2_nominal_dia       = 2;
m2_clearance_dia     = 2.4;
m2_head_dia          = 3.8;
m2_head_h            = 2;
m2_nut_af            = 4.0;
m2_nut_corner_dia    = 4.32;
m2_nut_h             = 1.6;
m2_trap_af           = 4.4;
m2_trap_depth        = 1.7;
m2_screw_len         = 8;
m2_min_surrounding   = 1;
m2_screw1_axis       = [0, 1, 0];
m2_screw2_axis       = [1, 0, 0];
hopper_export_rebase = 10.5;
guide_export_rebase  = 7;
bracket_export_rebase = 10.5;
export_rebases       = [hopper_export_rebase, guide_export_rebase, bracket_export_rebase];

// Approved guide frame and solids, in hopper-local coordinates.
guide_assembly_t     = [100, 34, 19];
guide_pipe_od        = 11.4; // Step 6: widened for the ~3mm-seed pipe
guide_x0             = -5;
guide_x1             = 5;
guide_y0             = -15.2;
guide_y1             = 15.2;
guide_floor_z0       = 7;
guide_floor_z1       = 8.7;
guide_rail_y0        = 7.7; // Step 6: rail inner face follows the wider pipe OD
guide_rail_y1        = 9.7; // Step 6: 2mm rail, 2mm gap to the pipe
guide_rail_z0        = 9.7;
guide_rail_z1        = 21.4;
guide_bridge_y0      = 7.7; // Step 6: follows the wider pipe OD
guide_bridge_y1      = 15.2;
guide_bridge_z0      = 9.7;
guide_bridge_z1      = 10.4;
guide_foot_y0        = 13;
guide_foot_y1        = 15.2;
guide_foot_z0        = 8.6;
guide_foot_z1        = 9.8;
guide_pad_x          = 3.7;
guide_pad_y0         = 7.7; // Step 6: follows the wider pipe OD
guide_pad_y1         = 11;
guide_pad_z0         = 11.3;
guide_pad_z1         = 18.7;
guide_screw1_x       = 0;
guide_screw1_z       = 15;
guide_screw1_y0      = 6.95;
guide_screw1_y1      = 11.05;
guide_trap_y0        = 9.3;
guide_trap_y1        = 11;

// ============================================================
// Crank (v79: at x=160, 20T gear meshes drum 40T at dist=60)
// Crank carries a 20T spur gear at the FRONT plane that meshes
// the drum's 40T gear. v102: 58mm hex shaft runs from the arm boss
// through the front-wall hex hole and full through the crank-gear
// hex bore (positive drive, 3-point support). Handle stands 20 off
// the front wall (arm inner face world y88 vs wall outer 68).
// grip orbit r=crank_throw=45, $fn=60, tol=0.3 all kept.
// ============================================================
crank_throw     = 45;
crank_mount_x   = crank_axle_x; // v79: 160: meshes drum 40T at dist 60 (was drum_axle_x=100)
crank_mount_y   = chassis_width + 8; // v79: 76: outside FRONT wall (68)
gear_local_y    = -24;       // crank gear local y; world y = crank_mount_y + gear_local_y = 52 (front, spans 49..55)
crank_side      = +1; // v79: grip/arm extend +Y outward front
crank_arm_t     = 4;
crank_arm_w     = 10;
grip_len        = 30;
grip_dia        = 16;
crank_pivot_x   = crank_arm_w / 2; // 5
crank_pivot_z   = crank_arm_t + hex_axle_r - 0.15; // ~8.47
hex_shaft_len   = 58;          // v102: 28+30 — arm boss, wall hole, full through gear bore
crank_arm_gap   = 12;          // v102: arm inner face 20 clear of front-wall outer (was 8)
crank_gear_hub_dia = 20;       // v140: spur_gear hub_dia on the crank gear (stations.scad)
crank_gear_hub_len = 8;        // v140: spur_gear hub_len; hub spans y 55..63 (north face)

// ============================================================
// Seed cradle
// ============================================================
cradle_u_depth  = 3;
cradle_u_radius = 4;

// ============================================================
// Seed tape with center U-fold bend (v28 true mimic of tapeubend.png,
// v31 drum-clear: forming station 37..70 fully west of the drum face).
// End-on photo (now in repo): flat 25.4 sheet -> tight narrow U trough
// 5-7 wide, inner R 1.5-2, vertical walls 5-6 deep pocket, small reverse
// S-kink at the shoulders flaring back to the flat wings, progressive
// flat-entry (shallow, at the roller nip) to full-U forming exit (deep,
// x=70); a straight full-U transit (same section, no taper) runs
// 70..126 under the drum (13.6 air gap to the disc) UNDER the hover
// pipe (10 gap), the seed drops at x=100 from the bore into the
// ALREADY-FOLDED pocket, on to the plow mouth (126) which closes it;
// stainless former collar (transverse shoe with U notch) rides over the
// forming exit (world x ~67) as a visual.
// Single-layer bottom (flat ribbon IS the trough floor, no double slab).
// Tape lane (v34 OD10 pipe: lowered lane 13 kept from v33; flat ribbon
// top 13.4, pipe bottom 23.4 (hover 10, no seal/slots), pipe top 33.4,
// flange bottom 33.5 -> flange-to-tape 20.1, disc bottom 35 -> 21.6;
// full-U transit top 21.15 clears the disc by 13.85, passes 2.25 under
// the pipe mouth with no touch).
// Single-layer bottom (flat ribbon IS the trough floor, no double slab).
// (S4) The retired fold's own dimensions - fold_width, tape_bend_radius,
// tape_fold_angle, tape_fold_wall, tape_shoulder_r/ang, tape_n_arc/tape_n_x -
// are DELETED: the v34 trough/R1.5/S-kink section they described no longer
// exists. The U of Step 6 is defined only by the u_* block below
// (u_flat_z, u_side_h, the developed-width identity) - nothing here sizes it.
// Assembly: static tape (viewer scrolls it); export standalone min_z=0.
// ============================================================
tape_thick       = 0.4;
tape_x0          = -14;   // Step10 DECOUPLED from chassis_x0 (was =chassis_x0): ribbon start fixed at spool approach; chassis west extends to -34 without dragging tape/dip. tape_len stays 234
// v45 WIND-UP LEADER (forensic fix: the flat ribbon used to run UNDER the
// bare reel core with a ~13 gap and dangle past the reel while the viewer
// scroll slid it +/-63 per rev). Now the flat ribbon ENDS at tape_flat_end
// (220: east of the nip caps 217, west of the reel flange 258) and a narrow
// leader strip (finished folded-tube width 8) climbs from the ribbon top onto
// the wound pack (pack r8 on core r5 at (274,50)), ending at (272.5,42.5)
// inside the pack silhouette.
tape_flat_end    = 220;
tape_len         = tape_flat_end - tape_x0;   // 234 (was 222: shifted +12 with stations)
leader_x0        = 218;   // leader start (2 overlap onto the flat ribbon)
leader_x1        = 272.5; // Step 4: leader endpoint inside the pack silhouette
leader_z1        = 42.5;  // Step 4: leader endpoint inside the pack silhouette
leader_w         = 8;     // leader width (finished folded tube, not full 25.4)
tape_z           = 28;           // v87 +15 lift: transit top 36.4, ribbon top 28.4

// Derived hopper-local references used by the fail-loud interface checks.
guide_tape_z0_local  = tape_z - (drum_axle_z - hopper_axis_z);
guide_tape_z1_local  = guide_tape_z0_local + tape_thick;
guide_pipe_z0_local  = guide_tape_z1_local + 10;
// ============================================================
// Step 6: dropper pipe, the new U under the dropper, its former,
// the guide cap that keeps the seeds in, and the 6-turner handoff.
// The old near-roller bend is gone (see the fold-station block
// above): the flat 25.4 ribbon is folded ONCE here, in the shadow
// of the dropper, then handed to the 6-turner already U-shaped.
// hopper_body() in scad/feed.scad no longer declares its own pipe locals:
// it reads the globals below directly and asserts drop_pipe_od == 11.4, so
// there is nothing shadowing them any more. entry_flare_leg is still the
// feed-side 0.6 lead-in leg; mouth_flare_leg is 0 (plain 1.2 joint ring).
// ============================================================
// --- Dropper pipe: widened so a ~3mm seed passes straight through ---
drop_pipe_id      = 9.0;   // was 7.6: a real ~3mm seed must clear the bore
drop_pipe_od      = 11.4;  // was 10
pipe_bore_r       = 4.5;   // was 3.8: == drop_pipe_id/2
pipe_wall         = 1.2;   // thinnest printable wall, unchanged by design
pipe_od_bottom_z  = 19.4;  // lower OD surface of the pipe (hopper-local z)
entry_flare_leg   = 0.6;   // bore exit 45deg lead-in leg (still >=0.6)
mouth_flare_leg   = 0;     // Step 6: joint ring is a plain 5.7-4.5 = 1.2 wall
                           // (no break leg); the only lead-in left is entry_flare_leg

// --- The new U under the dropper (hopper-local frame) ---
u_flat_z            = 9.2;   // U floor datum (u_centerline_top_z - u_side_h)
u_centerline_bottom_w = 10.4; // flat bottom centreline width (Y +-5.2)
u_side_h            = 7.5;   // vertical wall length from the flat datum
u_centerline_top_z  = 16.7;  // centreline top of the finished U
u_outer_top_z       = 16.9;  // outside top surface of the U walls
// THE REAL SECTION WIDTH. The paper is 25.4 wide and u_side_h of it rises on
// each side, so the floor's outer half width is what is left over; every
// builder (u_former_bar / u_former_wall) reads THIS, never a declared width.
u_floor_outer_w     = paper_width/2 - u_side_h;   // 5.2 (== u_centerline_bottom_w/2)
u_inner_w           = u_centerline_bottom_w - tape_thick; // 10.0  NOMINAL (see note)
u_outer_w           = u_centerline_bottom_w + tape_thick; // 10.8  NOMINAL (see note)
// NOMINAL ONLY: u_inner_w / u_outer_w describe the folded U on paper, but no
// geometry reads them - the formed section is built from u_floor_outer_w and
// u_shape(). Do NOT add an assert that treats them as the built width; assert
// the derived width instead (u_floor_outer_w, below). They are kept only as
// the paper's own nominal figures; the six-turner clearance is no longer
// quoted on them (the old throat check was false - see the EXIT fit check
// further down).
u_flat_end_x        = 81;    // flat sheet ends, fold starts
u_full_x            = 91;    // fold complete, full-depth U
u_stable_end_x      = 114;   // U stable + self-supporting (transit start)

// --- The seed packet roll (the round roll the tape becomes at the turner) ---
// Three sizes, three DIFFERENT owners - do not confuse them:
//   seed_dia_max   the seed itself. Real garden seeds are ~3mm; the old
//                  "8mm seeds" prose (and the 7.6 bore it justified) was
//                  WRONG and is gone.
//   seed_bore_d    the bore of the rolled packet. It is set by the PAPER -
//                  25.4mm of tape rolled up - and NOT by the seed. The user
//                  set the 6-turner EXIT to Ø8.5 ("around 7.5 / 8.5"); the
//                  EXIT is now Ø8.6, still inside that ask, so the packet
//                  must be smaller on radius: outer 7.9 inside an 8.6 throat.
//                  seed_bore_d 7.1 = that 7.9 outer minus one
//                  0.4 paper thickness. DO NOT try to shrink the packet to
//                  chase a smaller seed: the paper, not the seed, sizes it.
//   seed_passage_d the passage the packet travels through - the dropper
//                  bore, which must be at least as big as the packet.
// The EXIT of the six-turner is sized by the TAPE (a closed roll is 7.9
// across the outside), so it must stay >= 7.9 in diameter; that is why
// turner_exit_clear_r below is 4.30 (Ø8.6), not the 1.575 (Ø3.15) the old
// 6.5 taper produced, and why the scroll_sheet taper opens to
// scroll_clear_r(1) = 4.325 (see the scroll_* block further down).
seed_dia_max   = 3.0;         // user-confirmed real seed size
seed_bore_d    = 7.1;         // rolled packet bore
seed_passage_d = 9.0;         // == drop_pipe_id
roll_x0        = 100;         // drop point (seeds fall into the open U)
roll_x1        = 114;         // turner mouth
packet_bore_r  = seed_bore_d/2;                 // 3.55
packet_outer_r = packet_bore_r + tape_thick;    // 3.95  (Ø7.9)
// THE WRAP IS DERIVED, NEVER A HARDCODED 360.
// The 25.4mm strip turns about its own MEAN radius (the centreline radius
// of the paper in the roll), so the wrap it needs is paper_width divided by
// that mean radius:
//   packet_mean_r   = packet_bore_r + tape_thick/2 = 3.55 + 0.2 = 3.75
//   packet_wrap_rad = 25.4 / 3.75 = 6.7733 rad = 388.07 deg
// 388 > 360 by 28.07 deg: the strip laps 28.07 deg (1.84mm) OVER ITS OWN
// START. That overwrap IS the lap - there is no separate "leftover straight
// lap": the leftover after one 2*PI turn (25.4 - 2*PI*3.75 = 1.838) is
// exactly the paper that carries the overwrap, so packet_lap_len is 0 by
// construction and is asserted as such below. This is WHY the old
// packet_wrap_deg = 360 was wrong: a bare 360 at r 3.75 consumes only
// 23.56 of the 25.4 strip and leaves a 1.84mm open slit down the packet.
packet_mean_r   = packet_bore_r + tape_thick/2;          // 3.75
packet_wrap_rad = paper_width / packet_mean_r;           // 6.7733 (388.07 deg)
packet_wrap_deg = packet_wrap_rad * 180/PI;             // derived, never 360
packet_wrap_overlap_deg = packet_wrap_deg - 360;        // 28.07: the lap
packet_lap_len  = paper_width - packet_wrap_rad*packet_mean_r; // 0
// The packet rides on the SAME floor datum as the U it comes out of: its
// axis sits at packet_outer_r = 3.95 above the ribbon base, so the closed
// tube occupies exactly the U's own 7.9mm z envelope (0..7.9) and the morph
// has no vertical step at either end of the roll. See the assert on
// 2*packet_outer_r == u_side_h + tape_thick below.
packet_centre_z = packet_outer_r;                        // 3.95
// --- Morph resolution: 48 cross-section segments, 24 x-stations ----------
// 48 segments is fixed so P_U and P_TUBE are point-for-point lerp-able.
// 24 x-stations over the 14mm roll (100..114) gives 0.5833mm stations.
// The BITE is the overlap each box takes out of its neighbours along the
// cross-section. It is 0.10, NOT 0.02: at 0.02 a slightly bent (morphed) wall
// segment overlapped its neighbour almost coplanarly, the 20:1 sliver could not
// be fused reliably, and the union shed zero-thickness 2-face flakes at the
// first roll station (7 of them). 0.10 is ~19% of a 0.53mm segment - still a
// slight overlap, but a real volume to fuse. It costs 0.003 of packet corner
// radius, which is asserted against the 6-turner throat below.
// The X bite is the same idea along the roll. 0.20 is deliberate margin, not
// a flake fix: the cap stagger below shears a station by 0.047, and 0.20 keeps
// every pair of neighbouring stations overlapping in x by >= m_dx - 0.047.
packet_poly_seg      = 48;
packet_roll_stations = 24;
packet_seg_bite      = 0.10;  // cross-section overlap of neighbouring boxes
packet_x_bite        = 0.20;  // x overlap of neighbouring roll stations
// THE CAP STAGGER - the fix for the last zero-area flake, and the reason the
// roll reads watertight out of the STL. Every box in a station bites
// packet_seg_bite past its neighbour, so at any one end plane the 48 end-cap
// quads OVERLAP each other while sitting in the SAME plane. That coplanar
// overlap is the single boundary OpenSCAD's triangulation cannot resolve: it
// emits a zero-area triangle, and trimesh then reports the whole tape as
// "not watertight" even though OpenSCAD says manifold/NoError. Sweeping both
// cap planes by 0.001 per box (0.047 over the 48) removes the coplanarity and
// the flake with it - verified by isolation: 48 boxes, stagger 0 -> 1 flake,
// stagger 0.0005 -> 0 flakes. 0.047 of end raggedness is far below one
// printer layer, and the run still overlaps its neighbour station in x by at
// least m_dx - 47*0.001, so the chain is never in doubt.
packet_cap_stagger  = 0.001; // per-box x offset of the two cap planes
// The U centreline polyline: down the -Y wall, along the floor, up the +Y
// wall. 48 segments are split 14 / 20 / 14 so that BOTH corners fall exactly
// on a sample point - a uniform arclength split would straddle them and
// bevel the miter off by up to half a station.
u_poly_seg_wall  = 14;
u_poly_seg_floor = 20;
u_wall_cl_y   = u_centerline_bottom_w/2 - tape_thick/2;  // 5.0 wall centreline
u_floor_cl_z  = tape_thick/2;                            // 0.2 floor centreline
u_leg_cl_len  = u_side_h;                                // 7.5
u_floor_cl_len = u_centerline_bottom_w - tape_thick;     // 10.0
u_centreline_len = 2*u_leg_cl_len + u_floor_cl_len;      // 25.0 (see assert)

// --- Guide: rail gap to the widened pipe (named, asserted) ---
guide_pipe_gap   = 2.0;       // rail/bridge inner face to pipe OD

// --- Straight full-U transit, measured from the real fold stations ---
transit_start = u_stable_end_x;  // 114: fold complete, U stable and self-supporting
transit_end   = plow_start;      // 126: transit ends at the plow mouth
transit_len   = transit_end - transit_start; // 12: stable U -> plow mouth (via pipe)

// --- Guide cap: fused into u_guide(), holds the seeds in the pipe ---
guide_cap_x0        = -5;     // spans the existing guide x-envelope
guide_cap_x1        = 5;
guide_cap_y         = 7.9;    // 0.2 overlap onto the rail (never coplanar)
guide_cap_z0        = 17.8;   // 0.9 above the U top, 0.4 below the pipe OD
guide_cap_z1        = 19.0;
guide_cap_hole_d    = 9.2;    // seed passage, must pass the pipe bore
guide_cap_hole_x    = 0;

// --- New U-former part (u_former): forms the U, straddles the guide rail ---
former_x0  = 81;    // matches u_flat_end_x
former_x1  = 91;    // matches u_full_x
former_work_gap  = 0.15;  // work gap to the forming ribbon
former_capture_gap = 2.0; // relaxed capture gap past former_x1
former_capture_x0 = 89;   // == former_x1 - 2
former_ear_x0  = -14.1;   // ear into the widened bracket pad
former_ear_x1  = -8.3;
former_ear_y0  = 9.4;
former_ear_y1  = 11.0;
former_ear_z0  = 10.9;   // widened from 11.2: pad z span 10.9..18.1 (7.2 tall)
former_ear_z1  = 18.1;   // so the M2 hex corner wall reaches 1.0mm (was 0.76)

// --- M2 screws for the former (the guide keeps m2_screw_len = 8) ---
former_screw_len       = 6;    // head 2 + 0.9 + trap 1.7 + 1.4 thread = 6.0
former_screw_x         = -11.2;
former_screw_z         = 14.5;
former_screw_y_head    = 9.4;  // head seats here, shaft runs +Y
former_head_relief_d   = 4.2;  // head pocket, > m2_head_dia 3.8
former_screw_y_trap0   = 12.3; // hex trap
former_screw_y_trap1   = 14.0;
former_screw_y_tip     = 15.4; // head seat + former_screw_len

// --- Bracket pad: the former's M2 mounting pad, REAL MATERIAL in
// u_guide_bracket() (Step 6 B1). 6.6 square, widened from -13.7..-8.7 so the
// 4.4 AF nut trap cut into it (Step 6 B2) keeps m2_min_surrounding = 1.0 of
// pad across its flats (4.4 + 2*1.0 = 6.4 minimum, 6.6 built). The Z span is
// 10.9..18.1 (7.2 tall, deliberately widened from the old 11.2..17.8 = 6.6):
// across the hex's CORNERS the pad must also keep 1.0 of wall, and
// (z1-z0)/2 - (4.4/sqrt(3)) was only 0.76 at 6.6 tall - 1.06 now, and the
// whole point is that it clears the 1.0 FDM floor the assert in
// u_guide_bracket() holds it to. former_screw_z 14.5 is still EXACTLY the
// midpoint of the new span ((10.9+18.1)/2 = 14.5), so widening it moved no
// screw. The trap is centred on the pad: X centre (x0+x1)/2 = -11.2 =
// former_screw_x, Z centre (z0+z1)/2 = 14.5 = former_screw_z.
// pusher_pad_y1 = 14.0 (was 16.0) so the trap follows the Step 5 pattern
// EXACTLY: the hex is open at the pad's outer face and m2_trap_depth deep
// INTO it, i.e. former_screw_y_trap1 == pusher_pad_y1, with 1.3 of closed
// floor below it. A trap buried inside a 5mm pad (12.3..14.0 inside 11..16)
// would be an enclosed void: two shells instead of one and no way to get
// the nut in. The die ear seats on pusher_pad_y0.
pusher_pad_x0 = -14.5;
pusher_pad_x1 = -7.9;
pusher_pad_y0 = 11.0;   // == former_ear_y1: the die ear seats on this face
pusher_pad_y1 = 14.0;   // == former_screw_y_trap1: the trap opens here
pusher_pad_z0 = 10.9;   // == former_ear_z0
pusher_pad_z1 = 18.1;   // == former_ear_z1

// --- 6-turner handoff: the U arrives already formed ---
turner_axis_z       = 32;   // six_turner bore-axis height
turner_mouth_clear_r = 12;  // MOUTH clear radius: sheet wrap radius at 0 turns
turner_exit_clear_r  = 4.30;// EXIT clear radius (Ø8.6): the packet's own throat
                           // The user asked for "around 7.5 / 8.5"; the real
                           // exit bore is Ø8.6, still inside that ask - it has
                           // to be, because the fit is measured from the
                           // TURNER's axis and the packet axis sits 0.05 below
                           // it (packet_exit_ecc below). 4.30 keeps a full
                           // 0.3 gap on the radius; the old 4.25 (Ø8.5) left
                           // only 0.2375, under the 0.3 working clearance.
                           // - was 11.2 (turner_inner_r) which was really the
                           // mouth's inner face, not the exit; the old taper
                           // closed the exit down to 1.575 (Ø3.15), impassable
                           // - was 4.6 (Ø9.2), before the user set the exit to
                           // Ø8.5 to match the real rolled packet
u_center_world_z = 31.95; // U centre height in the assembly frame
// The packet's AXIS, in the assembly frame, is tape_z + packet_centre_z =
// 28 + 3.95 = 31.95. packet_centre_z is deliberately the U's own half
// envelope, so the packet seats inside the U's 0..7.9 box and the morph has
// no vertical step - but that leaves it 0.05 BELOW turner_axis_z (32, pinned
// to twister_axle_z and unable to move). Every exit fit must therefore be
// measured from the TURNER's axis: the true worst corner is
// 3.9625 (built packet) + 0.05, not the nominal 3.95.
packet_exit_ecc = abs(turner_axis_z - (tape_z + packet_centre_z));  // 0.05

// --- scroll_sheet()'s taper: the ONE number that opens the EXIT ------------
// These are the exact numbers the plow-side scroll_sheet() reads, so the
// taper cannot drift from the clearance it is sized for:
//   scroll_base_r(t) = 12 - scroll_exit_taper*t      (mouth r 12 -> exit 8.25)
//   spiral offset    = scroll_spiral_pitch * turns(t) * t
//   turns(t)         = 0.5 + 0.75*t                 (mouth U -> exit 1.25)
//   scroll_clear_r(t)= base_r(t) - spiral offset - thickness/2
//   scroll_clear_r(1)= 8.25 - 2.5*1.25 - 0.8 = 4.325  >= exit pin 4.30
// Solving for the taper X: r_clear(1) = 8.075 - X, so X = 8.075 - 4.30 =
// 3.775 would be the bare minimum; 3.75 is built, leaving 0.025 of margin.
// 4.325 is the mouth-side face of the exit; the packet's own axis is 0.05
// below the turner axis (packet_exit_ecc), so the real gap is
// 4.325 - 3.9625 - 0.05 = 0.3125 - a full 0.3 with the facet to spare.
scroll_base_r0      = 12;    // entry wrap radius (the 24mm U mouth)
scroll_exit_taper   = 3.75;  // X in base_r(t) = 12 - X*t
scroll_spiral_pitch = 2.5;   // radial loss per full turn of the spiral
scroll_entry_turns  = 0.5;   // mouth wrap (the U half-pipe)
scroll_exit_turns   = 1.25;  // exit wrap (1.0 + 0.25 overlap)
function scroll_turns(t)   = scroll_entry_turns + (scroll_exit_turns - scroll_entry_turns)*t;
function scroll_base_r(t)  = scroll_base_r0 - scroll_exit_taper*t;
function scroll_clear_r(t) = scroll_base_r(t) - scroll_spiral_pitch*scroll_turns(t)*t - thickness/2;
// The stations the packet fit is sampled at - the whole turner is checked,
// not just its exit.
packet_exit_check_t = [0, 0.25, 0.5, 0.75, 1];
function scroll_clear_r_min() = min([for (t = packet_exit_check_t) scroll_clear_r(t)]);

// --- Step 6 fail-loud checks (5 Laws: Fail Loud) ---
assert(abs((drop_pipe_od - drop_pipe_id)/2 - pipe_wall) < 0.001
    && pipe_wall == 1.2,
    str("Step 6: dropper pipe wall must stay 1.2: got ", (drop_pipe_od - drop_pipe_id)/2));
assert(pipe_bore_r == drop_pipe_id/2,
    str("Step 6: pipe bore radius must equal the pipe ID/2: ", pipe_bore_r));
assert(abs(pipe_od_bottom_z - guide_pipe_z0_local) < 0.001,
    str("Step 6: pipe OD bottom must stay at the local 19.4 datum: ", pipe_od_bottom_z));
assert(entry_flare_leg >= 0.6,
    str("Step 6: bore exit lead-in leg must stay >=0.6: ", entry_flare_leg));
assert(mouth_flare_leg == 0,
    str("Step 6: the joint ring is a plain wall - no mouth break leg: ", mouth_flare_leg));
// LENGTH CONSERVATION (S1): the sheet is 25.4 wide; the formed U keeps every
// millimetre of it - u_side_h rises on each side and what is left over is the
// floor, u_floor_outer_w on EACH side. Nothing is stretched, nothing is lost.
// (u_floor_outer_w is a HALF width - the same one the builders read from
// paper_width/2 - so the identity is half + one rise == half the sheet.)
assert(abs(u_floor_outer_w + u_side_h - paper_width/2) < 0.001,
    str("Step 6: the developed width must be conserved: floor half ", u_floor_outer_w,
        " + u_side_h ", u_side_h, " != half of paper_width ", paper_width/2));
assert(abs(u_floor_outer_w - u_centerline_bottom_w/2) < 0.001,
    str("Step 6: the derived floor half width must match the 10.4 centreline: ",
        u_floor_outer_w, " vs ", u_centerline_bottom_w/2));
assert(abs(u_centerline_top_z - (u_flat_z + u_side_h)) < 0.001,
    str("Step 6: U centreline top must be the flat datum plus u_side_h: ", u_centerline_top_z));
// The U outer top sits half a paper thickness above the centreline top: the
// wall CENTRELINE runs u_flat_z + u_side_h, its outer face half a thickness
// above that (u_former_wall builds h = u_side_h*u + tape_thick/2 + clearance).
assert(abs(u_outer_top_z - (u_flat_z + u_side_h + tape_thick/2)) < 0.001,
    str("Step 6: U outer top must be half a paper thickness above the centreline top: ",
        u_outer_top_z));
// Tie the NOMINAL widths to the derived geometry, so they cannot drift apart
// (see the NOMINAL note above - they are not what the builders read).
assert(abs(u_outer_w - (2*u_floor_outer_w + tape_thick)) < 0.001
    && abs(u_inner_w - (2*u_floor_outer_w - tape_thick)) < 0.001,
    str("Step 6: the nominal U widths must track the derived floor width: ",
        u_inner_w, "/", u_outer_w));
assert(u_flat_end_x == former_x0 && u_full_x == former_x1 && former_x1 > former_x0,
    str("Step 6: former span must match the fold span 81..91: ", former_x0, "..", former_x1));
assert(u_stable_end_x > u_full_x && u_stable_end_x < transit_end,
    str("Step 6: the U must be stable before the plow mouth: ", u_stable_end_x));
// --- Seed packet roll: the three sizes, and where each one must fit ---
assert(seed_dia <= seed_dia_max,
    str("Step 6: seed_dia must be <= seed_dia_max: ", seed_dia, " > ", seed_dia_max));
assert(packet_bore_r >= seed_dia_max/2 + tolerance,
    str("Step 6: the packet bore must pass the biggest seed with a tolerance gap: need >= ",
        seed_dia_max/2 + tolerance, " got ", packet_bore_r));
assert(seed_passage_d == drop_pipe_id,
    str("Step 6: the seed passage must equal the dropper bore: ", seed_passage_d,
        " vs ", drop_pipe_id));
assert(roll_x0 > u_full_x, "roll must start after the U is complete");
assert(roll_x1 == 114, "roll must finish at the turner mouth");
assert(roll_x0 < roll_x1 && roll_x1 == u_stable_end_x && roll_x1 == transit_start,
    str("Step 6: the roll must run from the drop to the turner mouth: ", roll_x0, "..", roll_x1));
assert(packet_wrap_rad > 2*PI,
    str("Step 6: the derived wrap must exceed a full turn (the packet genuinely closes): ",
        packet_wrap_deg, " deg got ", packet_wrap_rad, " rad vs ", 2*PI));
assert(packet_wrap_overlap_deg > 15,
    str("Step 6: the strip must lap its own start by a real overlap, not 0 deg: ",
        packet_wrap_overlap_deg));
// The straight-lap term is 0 BY CONSTRUCTION (the wrap is derived from the
// paper), and that is the point: the leftover after one 2*PI turn IS the
// overwrap. A nonzero leftover would mean the polyline needs a tangent lap.
assert(abs(packet_lap_len) < 0.001,
    str("Step 6: the straight lap must be absorbed by the derived overwrap: ",
        packet_lap_len));
// The wrap is measured on the MEAN radius of the paper in the roll, never on
// the bore - quoting 360 on the bore radius is what produced a slit packet.
assert(abs(packet_wrap_rad*packet_mean_r - paper_width) < 0.001,
    str("Step 6: the derived wrap must consume exactly the 25.4 strip: ",
        packet_wrap_rad*packet_mean_r, " vs ", paper_width));
assert(abs(packet_mean_r - (packet_bore_r + tape_thick/2)) < 0.001,
    str("Step 6: the wrap must be measured on the paper's MEAN radius: ",
        packet_mean_r));
// The closed packet occupies EXACTLY the U's own z envelope, so the morph has
// no vertical step at either end of the roll and the packet cannot climb
// into the drum.
assert(abs(2*packet_centre_z - (u_side_h + tape_thick)) < 0.001,
    str("Step 6: the packet must sit in the U's own z envelope: 2*",
        packet_centre_z, " = ", 2*packet_centre_z, " vs U height ",
        u_side_h + tape_thick));
// The polyline sample split must add up to the fixed 48 segments, and the U
// centreline must be the paper minus at most one corner mitre.
assert(u_poly_seg_wall*2 + u_poly_seg_floor == packet_poly_seg,
    str("Step 6: the U polyline split must total the fixed segment count: ",
        u_poly_seg_wall*2 + u_poly_seg_floor, " vs ", packet_poly_seg));
assert(abs(u_centreline_len - paper_width) <= tape_thick + 0.001,
    str("Step 6: the U centreline must be the 25.4 strip less one corner mitre: ",
        u_centreline_len, " vs ", paper_width));
// The MEASURED ENVELOPE, read off the actual sampled polyline (this is the
// same measurement the x=120 cross-section probe reports): every sample is a
// CENTRELINE point, so all of them must sit on the mean circle, and the bore
// / outer the built boxes produce is that circle less / plus half a thickness.
assert(abs(packet_poly_env_r_max() - packet_mean_r) < 0.001
    && abs(packet_poly_env_r_min() - packet_mean_r) < 0.001,
    str("Step 6: every packet sample must sit on the mean circle ", packet_mean_r,
        ": got ", packet_poly_env_r_min(), "..", packet_poly_env_r_max()));
assert(abs((packet_poly_env_r_min() - tape_thick/2) - packet_bore_r) < 0.001
    && abs((packet_poly_env_r_max() + tape_thick/2) - packet_outer_r) < 0.001,
    str("Step 6: the sampled packet must measure Ø", 2*packet_bore_r, "/",
        2*packet_outer_r, ": got Ø", 2*(packet_poly_env_r_min() - tape_thick/2),
        "/", 2*(packet_poly_env_r_max() + tape_thick/2)));
// And it must be the same packet at EVERY point of the roll, not just at
// x=114: the morph is monotone in u and the envelope follows u.
// NOTE - packet_exit_ecc is DELIBERATELY absent here, do not "harden" it blindly.
// This is an ENVELOPE guard, not the throat fit: packet_box_env_r_max() is the
// built packet's outermost box corner measured from the PACKET's own axis, and
// scroll_clear_r_min() is the sheet's tightest inner face measured from the
// TURNER's axis. The 0.05 between those two axes is a property of the TURNER
// datum, and it is asserted once, WITH it, in the exit check further down
// (packet_outer_r + packet_exit_ecc <= turner_exit_clear_r - tolerance, and the
// 4.325 - 4.0125 = 0.3125 arithmetic above). Folding it in here as well would
// assert the same physical fact a second time against a limit this check does
// not describe; it would not fail (3.9625 + 0.05 = 4.0125 <= 4.025) but it would
// make this envelope guard read as a second exit-fit check, and lose the point
// of keeping the two separate.
assert(packet_box_env_r_max() <= scroll_clear_r_min() - tolerance,
    str("Step 6: the built packet (box corners included) must pass the 6-turner: need <= ",
        scroll_clear_r_min() - tolerance, " got ", packet_box_env_r_max()));
// The morph is MONOTONIC in x - a roll that unrolls halfway is not a roll.
assert(roll_morph_max_backstep() <= 0,
    str("Step 6: the roll morph must be monotone in x: worst backstep ",
        roll_morph_max_backstep()));
assert(u_shape2(roll_x0) == 0 && u_shape2(roll_x1) == 1,
    str("Step 6: the morph must run 0 at the drop to 1 at the mouth: ",
        u_shape2(roll_x0), " -> ", u_shape2(roll_x1)));
assert(2*seed_bore_d >= 2*seed_dia_max + 2*tolerance,
    str("Step 6: the rolled packet bore must clear the seed: ", seed_bore_d,
        " vs ", seed_dia_max + 2*tolerance));
assert(abs(guide_pipe_gap - (guide_rail_y0 - guide_pipe_od/2)) < 0.001
    && guide_pipe_gap == 2.0,
    str("Step 6: guide rail must sit 2mm off the pipe OD: ", guide_pipe_gap));
assert(abs((guide_cap_y - guide_rail_y0) - 0.2) < 0.001,
    str("Step 6: guide cap must overlap the rail by 0.2 (never coplanar): ", guide_cap_y - guide_rail_y0));
assert(abs((pipe_od_bottom_z - guide_cap_z1) - 0.4) < 0.001,
    str("Step 6: guide cap must stop 0.4 below the pipe OD: ", pipe_od_bottom_z - guide_cap_z1));
assert(abs((guide_cap_z0 - u_outer_top_z) - 0.9) < 0.001,
    str("Step 6: guide cap must clear the U top by 0.9: ", guide_cap_z0 - u_outer_top_z));
assert(guide_cap_hole_d >= drop_pipe_id,
    str("Step 6: guide cap hole must pass the pipe bore: ", guide_cap_hole_d, " < ", drop_pipe_id));
assert(guide_cap_x0 == guide_x0 && guide_cap_x1 == guide_x1 && guide_cap_hole_x == 0,
    "Step 6: guide cap must span the guide x-envelope and be centred on x=0");
assert(former_capture_x0 == former_x1 - 2,
    str("Step 6: former capture notch must start 2mm before former_x1: ", former_capture_x0));
assert(abs((former_screw_y_head + former_screw_len) - former_screw_y_tip) < 0.001,
    str("Step 6: former screw tip must equal head seat + length: ", former_screw_y_tip));
assert(former_screw_len >= m2_head_h + 0.9 + m2_trap_depth + 1.4,
    str("Step 6: former M2 length has no margin left: need >= ", m2_head_h + 0.9 + m2_trap_depth + 1.4, " got ", former_screw_len));
assert(former_head_relief_d > m2_head_dia,
    str("Step 6: former head relief must clear the M2 head: ", former_head_relief_d));
assert(former_screw_y_head < former_screw_y_trap0 && former_screw_y_trap1 < former_screw_y_tip,
    str("Step 6: former M2 stack head < trap < tip must stay positive"));
assert(pusher_pad_x0 <= former_ear_x0 && pusher_pad_x1 >= former_ear_x1
    && pusher_pad_z0 == former_ear_z0 && pusher_pad_z1 == former_ear_z1,
    str("Step 6: the bracket pad must enclose the former ear with 1mm of material"));
assert((pusher_pad_x1 - pusher_pad_x0 - former_head_relief_d)/2 >= 1.0
    && (pusher_pad_z1 - pusher_pad_z0 - former_head_relief_d)/2 >= 1.0,
    str("Step 6: the 4.2 head pocket needs >=1.0mm of pad material each side: ",
        (pusher_pad_x1 - pusher_pad_x0 - former_head_relief_d)/2));
assert(pusher_pad_y0 == former_ear_y1,
    str("Step 6: the pad must start where the former ear ends: ", pusher_pad_y0));
assert(pusher_pad_x0 < former_screw_x && former_screw_x < pusher_pad_x1
    && pusher_pad_z0 < former_screw_z && former_screw_z < pusher_pad_z1
    && former_screw_y_trap0 > pusher_pad_y0
    && former_screw_y_trap1 == pusher_pad_y1,
    "Step 6: the former nut trap must sit inside the pad and break out at its outer face");
// FIT, against the EXIT - not the mouth, and not from the packet's own
// centre. The check that used to sit here compared the MOUTH's inner face
// (11.2) with the U's corner radius (sqrt(5.4^2 + 3.95^2) = 4.51) and passed
// with 6.7 to spare, which read like a generous throat. It measured the wrong
// end: the turner TAPERS, and the end that decides whether the packet gets
// out is the exit. It also measured from the wrong CENTRE: the packet axis
// (world 31.95) sits 0.05 below the turner axis (32), so the worst corner is
// 3.9625 + 0.05 = 4.0125 from the pin, not 3.95. So check the exit, with the
// eccentricity in: a closed roll of 25.4mm of paper at mean r 3.75 is 7.9
// across the outside, and the exit must clear half of that plus the 0.05
// offset plus one 0.3 working clearance (4.325 - 4.0125 = 0.3125).
// SAMPLED ACROSS THE WHOLE TURNER (t = 0, 0.25, 0.5, 0.75, 1), not just at
// the exit: the taper is monotone, so the exit is the binding station, and
// sampling it proves the whole spiral stays open for the packet.
//
// NOTE - the two checks below deliberately compare PACKET radius to SHEET
// radius, both taken about their OWN axis, and deliberately do NOT include
// packet_exit_ecc. Which limit each one uses is the whole point: these are
// "is the sheet wide enough for the closed packet" checks (packet_outer_r 3.95
// + one tolerance against the sheet's inner face, 4.325 at the tightest
// station). The turner-axis-relative fit - the only place the 0.05 eccentricity
// belongs - is asserted once, WITH it, in the exit check below
// (packet_outer_r + packet_exit_ecc <= turner_exit_clear_r - tolerance). Adding
// ecc to these as well would not fail (4.325 >= 3.95 + 0.05 + 0.3 = 4.30) but it
// would duplicate one physical fact across two different limits, and anyone
// tightening the exit pin later would then get two failures from one change
// instead of one.
for (t = packet_exit_check_t)
    assert(scroll_clear_r(t) >= packet_outer_r + tolerance,
        str("Step 6: the 6-turner must pass the closed Ø", 2*packet_outer_r,
            " packet (need >=", packet_outer_r + tolerance, ") at t=", t,
            ": got ", scroll_clear_r(t)));
assert(scroll_clear_r_min() >= packet_outer_r + tolerance,
    str("Step 6: the tightest station of the 6-turner is t=1 at r ",
        scroll_clear_r_min(), ", need >= ", packet_outer_r + tolerance));
assert(scroll_clear_r(0) == turner_mouth_clear_r - thickness/2,
    str("Step 6: the mouth clear radius and the t=0 sheet inner face must agree: ",
        turner_mouth_clear_r, " vs ", scroll_clear_r(0)));
assert(packet_outer_r + packet_exit_ecc <= turner_exit_clear_r - tolerance,
    str("Step 6: the packet outer, measured from the TURNER axis, must leave one tolerance of radial gap in the exit: need <= ",
        turner_exit_clear_r - tolerance, " got ", packet_outer_r + packet_exit_ecc,
        " (packet axis is ", packet_exit_ecc, " below the turner axis)"));
assert(2*turner_exit_clear_r >= 2*packet_outer_r,
    str("Step 6: the 6-turner EXIT must pass the closed Ø", 2*packet_outer_r,
        " packet: got Ø", 2*turner_exit_clear_r));
assert(scroll_clear_r(1) >= turner_exit_clear_r,
    str("Step 6: the built sheet's exit inner face must reach the exit pin: need >= ",
        turner_exit_clear_r, " got ", scroll_clear_r(1)));
assert(turner_mouth_clear_r > turner_exit_clear_r && u_center_world_z < turner_axis_z,
    str("Step 6: 6-turner handoff datums must stay consistent: mouth ", turner_mouth_clear_r,
        " > exit ", turner_exit_clear_r, "; U centre ", u_center_world_z, " < axis ", turner_axis_z));
assert(u_shape(former_x0) == 0 && u_shape(former_x1) == 1
    && abs(u_shape((former_x0 + former_x1)/2) - 0.5) < 0.001,
    str("Step 6: u_shape() must ramp 0 -> 1 across the former span"));

// Approved right bracket solids, before the assembly-side Y mirror.
bracket_plate_x0     = -5;
bracket_plate_x1     = 5;
bracket_plate_y0     = 11;
bracket_plate_y1     = 15;
bracket_plate_z0     = 10.5;
bracket_plate_z1     = 20;
bracket_arm_x0       = -24;
bracket_arm_x1       = 5;
bracket_arm_z0       = 10.5;
bracket_arm_z1       = 12;
bracket_flange_x0    = -26;
bracket_flange_x1    = -23.5;
bracket_flange_y0    = 7.4;
bracket_flange_y1    = 14.6;
bracket_flange_z0    = 10.5;
bracket_flange_z1    = 20;
bracket_screw1_y0    = 11;
bracket_screw1_y1    = 15.05;
bracket_screw2_x0    = -26.05;
bracket_screw2_x1    = -23.45;
bracket_screw2_y     = 11;
bracket_screw2_z     = 15;

// Positive-X source coordinates; hopper_body() mirrors these into the final
// negative-X side inside its existing union/difference.
hopper_boss_x0       = 26;
hopper_boss_x1       = 31.5;
hopper_boss_y0       = 7.4;
hopper_boss_y1       = 14.6;
hopper_boss_z0       = 10.5;
hopper_boss_z1       = 20;
hopper_web_x0        = 28;
hopper_web_x1        = 32;
hopper_web_y0        = 7.8;
hopper_web_y1        = 10.3;
hopper_web_z0        = 19;
hopper_web_z1        = 50;
hopper_boss_screw_x0 = 26.05;
hopper_boss_screw_x1 = 31.55;
hopper_boss_trap_x0  = 29.8;
hopper_boss_trap_x1  = 31.5;
hopper_boss_screw_y  = 11;
hopper_boss_screw_z  = 15;
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
