Vinayrnani/vseedtaper/scad/plow.scad

module scroll_sheet() {
    for (z = [0 : steps_length - 1]) {
        // t goes from 0.0 (entrance) to 1.0 (exit)
        t1 = z / steps_length;
        t2 = (z + 1) / steps_length;
        // How much it wraps around:
        // 0.5 = half circle (U-shape)
        // 1.25 = full circle + quarter overlap (The Spiral)
        turns1 = 0.5 + 0.75 * t1;
        turns2 = 0.5 + 0.75 * t2;
        for (a = [0 : steps_arc - 1]) {
            // Calculate angles for the 4 corners of this polygon patch
            angle1_1 = (a / steps_arc) * (turns1 * 360);
            angle1_2 = ((a + 1) / steps_arc) * (turns1 * 360);
            angle2_1 = (a / steps_arc) * (turns2 * 360);
            angle2_2 = ((a + 1) / steps_arc) * (turns2 * 360);
            // Base radius shrinks from 12mm (24mm wide U) down to 8.25mm.
            // THE TAPER EXISTS FOR ONE REASON: the EXIT clear radius. With
            // the old 6.5 the exit closed to r 1.575 (Ø3.15) - the packet
            // roll (Ø7.9 across the outside) could never get out.
            //   r_clear(t) = base_r(t) - scroll_spiral_pitch*scroll_turns(t)*t
            //                - thickness/2
            //   r_clear(1) = (12 - X) - 2.5*1.25 - 1.6/2 = 8.075 - X
            //   X = 8.075 - 4.30 = 3.775 is the bare minimum; 3.75 is
            //   built, leaving 0.025 of margin -> r_clear(1) = 4.325
            // where -2.5*1.25 = -3.125 is the spiral offset of the 1.25
            // turns at the exit and 0.8 is the half sheet thickness.
            // (Every scroll_* number below - the taper AND the spiral tuck -
            // is read from the shared names in params.scad, so this taper
            // and the exit-clearance check cannot drift apart.)
            base_r1 = scroll_base_r0 - scroll_exit_taper * t1;
            base_r2 = scroll_base_r0 - scroll_exit_taper * t2;
            // Spiral offset: the radius shrinks slightly as it wraps around so it tucks INSIDE itself without colliding
            r1_1 = base_r1 - (angle1_1 / 360) * scroll_spiral_pitch * t1;
            r1_2 = base_r1 - (angle1_2 / 360) * scroll_spiral_pitch * t1;
            r2_1 = base_r2 - (angle2_1 / 360) * scroll_spiral_pitch * t2;
            r2_2 = base_r2 - (angle2_2 / 360) * scroll_spiral_pitch * t2;
            // Convert to 3D Cartesian coordinates
            p1 = [ r1_1 * cos(angle1_1), r1_1 * sin(angle1_1), t1 * length ];
            p2 = [ r1_2 * cos(angle1_2), r1_2 * sin(angle1_2), t1 * length ];
            p3 = [ r2_1 * cos(angle2_1), r2_1 * sin(angle2_1), t2 * length ];
            p4 = [ r2_2 * cos(angle2_2), r2_2 * sin(angle2_2), t2 * length ];
            // Create a solid sheet segment between the 4 points
            hull() {
                translate(p1) sphere(d=thickness, $fn=6);
                translate(p2) sphere(d=thickness, $fn=6);
                translate(p3) sphere(d=thickness, $fn=6);
                translate(p4) sphere(d=thickness, $fn=6);
            }
        }
    }
}
// v65: printable_folder() wrapper + BOTH user tabs DELETED per user
// (right tab floated disconnected in every orientation, v64 probe;
// left tab lay across the trench opening and blocked the tape flow).
// The part is the bare scroll_sheet() placed in six_turner() below.
// ---- end verbatim user code ----

module six_turner() {
    // ---- v64 bare folder (verbatim user code only, no added solids) ----
    // Orientation: roll -90 about the tube axis (entry half-pipe opens
    // UP into a U) then +90 about Y (tube axis -> +X, mouth west).
    // Placement: mouth 12 west of the slot so the exact 45 length ends
    // precisely on the slot end 159 (twister gap untouched); axis 21
    // (entry floor ~9.8 under the ribbon, exit tube ~15..27 threading
    // toward the twister ring). All v63 wrapper solids (pedestals,
    // straps, ears, tab post, tray, nose) deleted per user: the part
    // is exactly printable_folder(), screwed down via its own tabs.
    // ---- v66 twister-aimed mounts (bare sheet kept) ----
    // Axis 28 (v87 +15 from 13): exit bore lands DEAD on the twister
    // bore (assembly lifts +base_thick=4 -> world 32 = twister_axle_z,
    // local y 20 + plow_frame_y0 14 = world 34 = lane centre), so the exit
    // faces the twister straight; entry mouth rims sit at lane height.
    // Supports: 2 ground pedestals fused under the sheet floor (tops +15:
    // 19.3/22.7). v141: no legs - each pedestal IS a foot, carrying one
    // vertical M3 at world (133,34) / (151,34).
    cy = plow_axis_local_y;         // sheet centre (local y, world tape centre 34 = lane_y)
    axis_z = 28;                    // v87 +15: sheet axis height (exit = twister bore height)
    mouth_x0 = -12;                 // sheet mouth (world 114, exit lands 159)
    pedA = [4, 10, 12, 28, 19.3];    // Step 9: widened X to 6 (world 130..136), top/embed unchanged
    pedB = [22, 28, 14, 26, 22.7]; // Step 9: widened X to 6 (world 148..154), top/embed unchanged
    // ---- v143: BOTH screws are fitted from above, one per short L-arm ----
    // Arm A (north) stops plow_arm_gap short of the fixed wall. Arm B (south)
    // grows off pedestal B into the only sky-clear band south of the scroll
    // (world y 55.7..64.8, 41mm below the crank/drum gear rim). Each hole is a
    // GENUINE through hole and each head sits on its arm's top face.
    hole_d = bolt_dia + 2*tolerance; // M3 clearance 3.6
    screw_a = [plow_screw_a_x - plow_start, plow_screw_a_y - plow_frame_y0]; // 6, 4
    screw_b = [plow_screw_b_x - plow_start, plow_screw_b_y - plow_frame_y0]; // 22, 42
    // Arm A, derived from the screw and the gap so the two cannot disagree.
    arm_x0 = screw_a[0] - plow_arm_w/2;                             // 3  (world 129)
    arm_x1 = arm_x0 + plow_arm_w;                                     // 9  (world 135)
    arm_y0 = screw_a[1] - hole_d/2 - plow_arm_end_ligament;          // 1  (world 15)
    arm_y1 = pedA[2] + plow_arm_fuse;                                 // 15 (world 29)
    // Arm B, the same construction mirrored: it reaches south past pedestal B
    // to the free band, so its end is the free band's edge and its far end
    // overlaps the pedestal.
    arm2_x0 = screw_b[0] - plow_arm2_w/2;                            // 19 (world 145)
    arm2_x1 = arm2_x0 + plow_arm2_w;                                  // 25 (world 151)
    arm2_y0 = pedB[2] - plow_arm2_fuse;                               // 23 (world 37)
    arm2_y1 = screw_b[1] + hole_d/2 + plow_arm2_end_ligament;         // 45 (world 59)
    sheet_y0 = cy - scroll_base_r0 - thickness/2;                     // 7.2 (world 21.2)
    sheet_y1 = cy + scroll_base_r0 + thickness/2;                     // 32.8 (world 46.8)
    // ---- v63 fail-loud: exact-scroll placement ----
    assert(turner_len == 33 && plow_start == 126 && turner_end == 159,
        "six_turner: slot datum must stay 126..159");
    // Exact-use proofs (user code must stay byte-identical).
    assert(length == 45, "six_turner: folder length must stay exactly 45");
    assert(thickness == 1.6, "six_turner: sheet must stay exactly 1.6");
    assert(steps_length == 35 && steps_arc == 35, "six_turner: resolution must stay 35/35");
    // The taper arithmetic, proven, not asserted by faith: the exit must be
    // open enough for the paper roll (Ø7.9 outside -> exit Ø8.6, one 0.3
    // working clearance on the radius plus the 0.05 axis offset).
    assert(scroll_exit_taper == 3.75, "six_turner: the exit taper must stay 3.75");
    assert(scroll_base_r(1) == 8.25, "six_turner: exit base radius must be 8.25");
    assert(scroll_entry_turns + (scroll_exit_turns - scroll_entry_turns) == 1.25,
        "six_turner: exit must wrap 1.25 turns (spiral overlap)");
    // The exit INNER face radius those two facts produce, against the pin:
    //   8.25 - 2.5*1.25 (spiral) - 1.6/2 (half sheet) = 4.325 >= 4.30
    assert(scroll_clear_r(1) >= turner_exit_clear_r,
        str("six_turner: exit clear radius must reach the pin ", turner_exit_clear_r,
            ": got ", scroll_clear_r(1)));
    // And the packet itself must clear the whole sheet, sampled across it -
    // not just at the exit, where the packet is a built box, not a circle.
    // Measured from the TURNER's axis, not the packet's own: the packet axis
    // is packet_exit_ecc below it, so the worst corner is 3.95 + 0.05.
    assert(packet_outer_r + packet_exit_ecc <= turner_exit_clear_r - tolerance,
        str("six_turner: the packet must leave a tolerance gap in the exit: need <= ",
            turner_exit_clear_r - tolerance, " got ", packet_outer_r + packet_exit_ecc,
            " (packet axis is ", packet_exit_ecc, " below the turner axis)"));
    assert(scroll_clear_r_min() >= packet_outer_r + tolerance,
        str("six_turner: the tightest station must pass the Ø", 2*packet_outer_r,
            " packet: need >= ", packet_outer_r + tolerance, " got ", scroll_clear_r_min()));
    assert(2*turner_exit_clear_r >= 2*packet_outer_r,
        str("six_turner: the exit must pass the Ø", 2*packet_outer_r,
            " packet: got Ø", 2*turner_exit_clear_r));
    // Placement: mouth 14 after the drop (flat landing kept), exit
    // exactly on the slot end (twister gap untouched).
    assert(mouth_x0 + plow_start == 114, "six_turner: mouth must sit at world 114");
    assert(mouth_x0 + length + plow_start == turner_end, "six_turner: exit must land on 159");
    assert(cy == 20, "six_turner: sheet must stay centred on the tape (local 20, world 34 = ring centre)");
    assert(axis_z == 28, "six_turner: axis must stay 28 (exit bore meets twister bore)");
    assert(axis_z + base_thick == twister_axle_z, "six_turner: exit axis must meet the twister bore height (world 32, assembly at base_thick)");
    assert(axis_z == 28 && axis_z + base_thick == 32, "six_turner: +15 lift stack (axis 28 local + base 4 = world 32)");
    assert(axis_z - 12 - thickness/2 >= 0.1, "six_turner: mouth floor must stay above the base");
    // Pedestal fuse: tops embed ~0.4 into the sheet floor wall
    // (floor outer ~18.9 mid / ~22.3 exit, wall 1.6, void stays clear).
    // v87 +15 lift: ped tops +15 (4.3→19.3, 7.7→22.7) to meet lifted axis_z=28.
    assert(pedA[4] >= 18.5 && pedA[4] <= 20.0, "six_turner: mid pedestal top must land in the floor wall");
    assert(pedB[4] >= 21.8 && pedB[4] <= 23.9, "six_turner: exit pedestal top must land in the floor wall");
    assert(abs(pedA[4] - 19.3) < 0.001 && abs(pedB[4] - 22.7) < 0.001,
        "six_turner: pedestal tops must be +15 lift values (19.3 / 22.7)");
    assert(pedA[0] >= mouth_x0 && pedA[1] <= mouth_x0 + length, "six_turner: mid pedestal must sit under the sheet");
    assert(pedB[0] >= mouth_x0 && pedB[1] <= mouth_x0 + length, "six_turner: exit pedestal must sit under the sheet");
    // ---- v143: side A, the top-down screw and its short L-arm ----
    // A used to hang off a 24mm floor strap that stopped 1mm from the fixed
    // wall - that reach is what the user objected to. The arm is now 14mm long
    // with an 11mm overhang past the pedestal and stops 12mm short of the wall,
    // and the screw's head sits on the arm's TOP face in open sky.
    assert(plow_screw_a_x == plow_start + 6 && plow_screw_a_y == 18,
        "six_turner: the north screw must be at world (132,18)");
    // The arm's ligaments around the hole: 1.2 west and east (a 6mm arm hosting
    // a 3.6mm bore is the limit: (6-3.6)/2 = 1.2) and 1.2 to the arm's end
    // face. Toward the pedestal the arm is solid, so there is no fourth face.
    assert((screw_a[0] - arm_x0 - hole_d/2) >= plow_foot_ligament
        && (arm_x1 - screw_a[0] - hole_d/2) >= plow_foot_ligament
        && (screw_a[1] - arm_y0 - hole_d/2) >= plow_foot_ligament,
        str("six_turner: the north screw must keep ", plow_foot_ligament,
            "mm ligaments in arm A; got W ", screw_a[0] - arm_x0 - hole_d/2,
            " E ", arm_x1 - screw_a[0] - hole_d/2,
            " N ", screw_a[1] - arm_y0 - hole_d/2));
    // The head is the only thing of this screw above the arm, and it lives
    // NORTH of the scroll: its footprint stops short of the sheet's south face
    // (local sheet_y0 7.2 vs the head's north edge 6.75), so no part of the
    // screw or its head can ever be inside the rolled paper.
    assert((screw_a[1] + bolt_head_across/2) <= sheet_y0,
        str("six_turner: the north head must stay clear of the scroll's south face: got ",
            screw_a[1] + bolt_head_across/2, " vs sheet ", sheet_y0));
    // The arm is a cantilever, but it must FUSE into the pedestal, never touch
    // it: the overlap has to be positive in x AND y, or the union splits into
    // a floating second body. Measured: 5mm in x, plow_arm_fuse 3mm in y.
    assert((min(arm_x1, pedA[1]) - max(arm_x0, pedA[0])) >= plow_foot_ligament
        && (arm_y1 - pedA[2]) >= plow_foot_ligament
        && arm_y0 < pedA[2],
        "six_turner: arm A must overlap pedestal A volumetrically, not touch it");
    // The overhang past the pedestal face is 10..15mm: long enough to be an L,
    // short enough that the wall gap is plainly visible.
    assert((pedA[2] - arm_y0) >= 10 && (pedA[2] - arm_y0) <= 15,
        str("six_turner: arm A's overhang must be 10..15mm, got ", pedA[2] - arm_y0));
    // ---- v143: side B, the same L mirrored, into the free band ----
    assert(plow_screw_b_x == plow_end - 8 - plow_arm2_w/2 && plow_screw_b_y == 56,
        "six_turner: the south screw must be at world (148,56)");
    // Same three ligaments, mirrored: 1.2 E/W and 1.2 to arm B's south end.
    assert((screw_b[0] - arm2_x0 - hole_d/2) >= plow_foot_ligament
        && (arm2_x1 - screw_b[0] - hole_d/2) >= plow_foot_ligament
        && (arm2_y1 - screw_b[1] - hole_d/2) >= plow_foot_ligament,
        str("six_turner: the south screw must keep ", plow_foot_ligament,
            "mm ligaments in arm B; got W ", screw_b[0] - arm2_x0 - hole_d/2,
            " E ", arm2_x1 - screw_b[0] - hole_d/2,
            " S ", arm2_y1 - screw_b[1] - hole_d/2));
    // Same volumetric fuse into pedestal B, measured the same way: 3mm in x
    // (arm B is 19..25, pedestal B is 22..28) and plow_arm2_fuse in y.
    assert((min(arm2_x1, pedB[1]) - max(arm2_x0, pedB[0])) >= plow_foot_ligament
        && (pedB[2] - arm2_y0) >= plow_foot_ligament
        && arm2_y1 > pedB[2],
        "six_turner: arm B must overlap pedestal B volumetrically, not touch it");
    // Arm B reaches SOUTH past the pedestal, and the paper lane is north of it:
    // the arm may not climb into the sheet, or the scroll would be fouled.
    assert(arm2_y0 > sheet_y1 || arm2_y1 > sheet_y1,
        "six_turner: arm B must grow away from the sheet, not into it");
    // Both bores are THROUGH, not blind, and the geometry that makes them so is
    // named here so it can be asserted instead of assumed: each bore starts
    // BELOW the arm's bottom face (z0) and ends ABOVE its top face, so it
    // necessarily breaks out at both ends - nothing caps it at the bottom for
    // the nut, and the head lands on the top face.
    bore_a_z0 = -epsilon;  bore_a_h = plow_arm_h + 2*epsilon;
    bore_b_z0 = -epsilon;  bore_b_h = plow_arm2_h + 2*epsilon;
    assert(bore_a_z0 < 0 && bore_a_z0 + bore_a_h > plow_arm_h
        && bore_b_z0 < 0 && bore_b_z0 + bore_b_h > plow_arm2_h,
        str("six_turner: both bores must be THROUGH - they must start below z0 and "
            , "end above the arm top; A ", bore_a_z0, "..", bore_a_z0 + bore_a_h,
            " of 0..", plow_arm_h, ", B ", bore_b_z0, "..", bore_b_z0 + bore_b_h,
            " of 0..", plow_arm2_h));
    // Both heads sit on top of an arm in open sky, and the highest thing either
    // screw puts above the chassis floor is the head: base_thick 4 + arm 10 +
    // head 2 = 16, with the packet lane starting at tape_z 28.
    for (h = [plow_arm_h, plow_arm2_h])
        assert(base_thick + h + m3_head_h <= tape_z - 5,
            "six_turner: both arms and heads must stay >=5mm below the packet lane");
    assert(base_thick + plow_arm2_h + m3_head_h <= drum_axle_z - 20,
        str("six_turner: the south head must stay clear of the gear plane; drum gear bottom ",
            drum_axle_z - 42));
    // ---- v143: the part's Y footprint, and what is allowed outside the sheet ----
    // The two feet and the sheet stay inside the sheet's Y span; the two arms
    // are the only solids outside it, and they are the things that stop short
    // of their walls. Nothing else can creep out.
    assert(pedA[2] >= sheet_y0 && pedA[3] <= sheet_y1
        && pedB[2] >= sheet_y0 && pedB[3] <= sheet_y1,
        "six_turner: both feet must sit inside the sheet's Y span");
    assert(arm_y0 < sheet_y0 && arm2_y1 > sheet_y1
        && arm_y0 <= min([pedA[2], pedB[2], arm2_y0])
        && arm2_y1 >= max([pedB[3], sheet_y1, arm_y1]),
        "six_turner: the two arms alone may reach outside the sheet's Y span, and they define the part's Y extremes");
    // The footprint is arm A's end to arm B's end: 20..46mm. The old
    // wall-reaching legs, plus the ear that reached to y 66, made it 62.
    assert((arm2_y1 - arm_y0) <= plow_foot_max_span
        && (arm2_y1 - arm_y0) >= 20,
        str("six_turner: the plow Y footprint must be 20..", plow_foot_max_span,
            " (it was 62 with the wall-reaching legs and the y=66 ear): got ",
            arm2_y1 - arm_y0));
    // ---- v143: the walls, the gears and the lane, for BOTH stations ----
    // Both stations clear the fixed north wall (y 0..3) by more than the hole
    // radius and than the nut trap's circumradius.
    assert(min(plow_screw_y) - wall_screw_clearance_d/2 > wall_thick
        && min(plow_screw_y) - wall_screw_nut_r > wall_thick,
        "six_turner: both floor screws must clear the fixed wall's inner face");
    for (i = [0:1])
        assert(tw_apex_x_frame - plow_screw_x[i] >= 10
            && (v98_Bx - tw_bevel_outer_r) - plow_screw_x[i] >= 10,
            str("six_turner: floor screw ", i, " must stay >=10mm west of the apex / "
                , "B bevel western envelope"));
    // Arm A's head clears the teeth band in y; arm B reaches into the band in y,
    // so for B the relief is X - the teeth only exist east of the bevel
    // envelope, 38.75mm east of screw B.
    assert(v98_Bbev_y0 - (plow_screw_a_y + bolt_head_across/2) >= 1.0
        && (v98_Bx - tw_bevel_outer_r) - max(plow_screw_x) >= 10,
        "six_turner: the heads must clear the B teeth band (A in y, B in x)");
    // B-side checks that stay on y: pedB is south of the teeth band, and its
    // top clears the B shaft.
    assert(v98_Bbev_y0 - (plow_frame_y0 + pedB[3]) >= 10, "Step-9 pedB north must stay below the teeth band");
    assert(v98_Bz - 4 - (base_thick + pedB[4]) >= 1, "Step-9 pedB top must clear the B shaft");
    // No added solids: the part is exactly printable_folder().
    // Seeded pocket core must thread the 24-wide entry mouth.
    assert(12 - sqrt(pow(3.9, 2) + pow(3.4, 2)) >= 0.1,
        "six_turner: seeded pocket core must thread the entry mouth");
    // v143 solid: bare user scroll sheet (oriented + placed) + the 2 floor
    // pedestals + TWO short L-arms, one off each pedestal (union). Both screws
    // are fitted from above: each head sits on its arm's top face and each hole
    // passes clean through. Nothing reaches a wall any more - arm A stops 12mm
    // short of the fixed wall, arm B 6mm short of the south gear wall.
    // The $fn=6 spheres inside the user code
    // stay untouched (1225 hulls: $fn=60 spheres would not render).
    union() {
        difference() {
            union() {
                // Bare sheet: roll -90 about the tube axis (entry
                // half-pipe opens UP into a U), +90 about Y (tube axis
                // -> +X, mouth west), then placed on the lane.
                translate([mouth_x0, cy, axis_z])
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
