Vinayrnani/vseedtaper/(commit log)

2026-09-16 chore(viewer): fix gear mesh, drum axle, crank orbit + regenerated GLBs
    [cartridge.stl, chassis.stl, cones.stl, crank.stl, hopper.stl, plow.stl, rollers.stl, shroud.stl]
2026-09-16 chore(requirements): v3 gear-mesh + crank-motion fix, add changelog
2026-09-16 fix(viewer): fit all parts inside chassis from measured scad+GLB transforms (v4)
    - Root cause: mixed frames (M-mapped pivots + root rotation.x=-90 = double
    rotation); PART_DEFS were centroid-centering hacks scattering parts.
    - SCHEME M: root.rotation.x=0, OpenSCAD->three map baked into every part;
    pivots at M(A), child rot=M_R.Q, pos=M_R.(B+d). Rotation signs unchanged.
    - cartridge/shroud/hopper/plow/cones/rollers/crank pos+rot re-derived from
    animated_assembly() + trimesh GLB bounds; pinion gear plane y=47.95 = drum.
    - crank grip orbit radius 44.964 const over 4 frames (surface-centroid probe;
    old [0,45,0] measured the node origin, true grip was r=86).
    - Regenerated rollers_lower/up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
    [seed_tape_machine_v2.scad]
2026-09-16 chore: save state before gear and hopper/drum fixes
    [_cartridge_horizontal.scad, cartridge.stl, chassis.stl, cones.stl, crank.stl, hopper.stl, plow.stl, rollers.stl]
2026-09-16 feat(hopper/shroud): sketch rebuild - open funnel + taper chute, 180-deg thin shroud, M3 joint flanges (v6)
    [seed_tape_machine_v2.scad]
2026-09-16 chore: pre-ccw-righthopper-rebuild snapshot (safe point before crank+hopper.jpg rebuild)
    [seed_tape_machine_v2.scad]
2026-09-16 feat(hopper/shroud/drive): CCW drum + right wedge hopper + left shroud per crank+hopper.jpg (v8)
    - drum ANTI-CLOCKWISE (top moves -X), crank/lower CW, upper CCW; 2:1 ratio kept
    - hopper mirrored to +X right: open wedge, upper lip 1:30, lower lip 3 o'clock +7deg up-tilt, tangent mouth gap 1.0
    - shroud mirrored left (+60..+240deg), plain thin shell, viewer mounts unchanged
    - viewer rotation.z signs flipped; cartridge mount restored to [0,0,7.5]/[PI,0,0] (was standing drum vertical, pre-existing)
    - GLBs regen: hopper/shroud/crank; Playwright: 0 errors, CCW/CW verified, mouth r26.00
    [seed_tape_machine_v2.scad]
2026-09-16 feat(hopper/shroud/drop): hopper2 wedge + corner drop tube + left-C shroud (v9)
    [hopper.stl, seed_tape_machine_v2.scad, shroud.stl]
2026-09-16 feat(hopper): single wrap-around hopper, shroud merged/removed (v10)
    - hopper_body(): left retention cover arc 45..240deg (wall 2, gap 1.5)
    fused at 1:30 step tab replaces separate shroud; right wedge + corner
    drop tube unchanged; one watertight component
    - u_channel_shroud kept as legacy stub (viewer no longer loads it)
    - web/index.html: shroud toggle/pivot removed, hopper relabelled
    wrap-around, legend updated
    - hopper.glb/stl regenerated; mirror-check proves viewer not mirrored
    (wedge apex world +83 toward crank side); drum CCW, crank r=45 kept
    [hopper.stl, seed_tape_machine_v2.scad]
2026-09-16 feat(layout): right-pickup, left-drop, left-crank direct-drive (v11)
    [crank.stl, hopper.stl, seed_tape_machine_v2.scad]
2026-09-16 feat(hopper): bottom-center drop, 11-to-6 cover, level wedge top (v12)
    - Wedge top edge exactly horizontal (cheek tops z=73.000 flat, x20-79).
    - Retention cover re-clocked 45..240 -> 120..270deg (top lip 11 o'clock,
    bottom lip 6 o'clock at drop tube); gap 1.5 smooth annular channel.
    - Drop tube moved left x=67 -> bottom-center x=100 (bore 7, 0.5 above
    tape; tape 35->30 under drum; carve-sculpted funnel mouth, no ribs).
    - Eyebrow bridge 30..125deg keeps ONE single connected hopper object
    with mouth open (verified 1 STL component).
    - Viewer: dropSeed path (100, 30.5->30), tape y=30, legend + part label.
    - Verify: 0 console errors, CCW right->top->left->bottom, crank r=45
    left direct-dr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
    [hopper.stl, seed_tape_machine_v2.scad]
2026-09-16 docs(req): v13 refinements - closed hopper, 11-6 open shroud 16mm/8mm, 6 cavities, matching grooves (MVP)
2026-09-16 feat(v13): closed hopper + 2 side joints, half-pipe 16/8 cover 11-6 with grooves, 6 cavities, bore 9, spacing 152.4 + gear chart
    [seed_tape_machine_v2.scad]
2026-09-16 feat(v14): full v14 geometry+docs - tube outer -9..9, RED/BLUE/PINK/YELLOW markup in scad, echoes v13->v14
    Geometry: drop tube outer -10..10 -> -9..9 per v14 spec; bore kept 9mm
    (-4.5..4.5, 8mm-compatible - retains v13 8mm-seed bore, walls 4.5).
    RED: no blocking rib in 120..270 channel verified (smooth, grooves only).
    BLUE: 2 side-joint hulls retained. PINK: apex end wall + sides seal
    container (hopper STL vol 8305.7 -> 8130.1, bounds unchanged
    x -28.5..83, z 26.5..81.8). YELLOW: w7xd0.8 cover+floor grooves noted
    positioning-only (not seed drive). Shroud stays legacy stub,
    part_to_render names unchanged; seed_tape_machine.scad, web/backup untouched.
    Verify: 12/12 openscad exports exit 0, v1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
    [seed_tape_machine_v2.scad]
2026-09-16 feat(v15): actual changes.jpg markups - interface fit, tab relief, tip/wall
    [seed_tape_machine_v2.scad]
2026-09-16 perf(regen): parallel xargs -P$(nproc) STL+GLB + skip-unchanged cache (--force)
    Full regen ~110s serial -> ~55s on 4 cores; no-change re-run ~0.1s.
    Cache: .regen_cache/<part>.sha256 over per-part temp scad.
    No CAD/viewer/v1 changes ($fn=60, tolerance=0.3 intact).
2026-09-16 fix(v15): deployment gap — stale tab comment, ?v=3 cache-bust so users see new geometry
    [seed_tape_machine_v2.scad]
2026-09-16 fix(v16): closed bowl tip + sides-only joint, gap back to 1.0, drop plow chamfer
    [seed_tape_machine_v2.scad]
2026-09-16 feat(v17): hopper mouth fixes — RED pads deleted, BLUE arc side-fins, PINK watertight tip
    RED: removed 2 diagonal side-joint pads crossing the cavity sweep annulus.
    BLUE: cheek roots x14-24 + arc fins r26.5-28.5 30-122deg fuse root to cover
    lip; mouth sides closed, middle open gap 1.0. v16 trough was 2 disjoint
    solids; v17 is a single watertight solid (scraper area 46.0->5.8mm2).
    PINK: floor to x84, 6-thick nose x78-84, void ends x70, 2-wide tip blocks.
    Regen hopper.glb/stl, ASSET_V 5->6. REQUIREMENTS v17.
    [hopper.stl, seed_tape_machine_v2.scad]
2026-09-16 fix(v19): seal hopper triangular gaps — deep cheeks, wide floor, big nose, root gussets
    [hopper.stl, seed_tape_machine_v2.scad]
2026-09-16 feat(v20): drum gear to back side Y~12, ASSET_V 8
    [seed_tape_machine_v2.scad]
2026-09-16 feat(v21): crank+roller west to x=40, back-side gears meshed with 9deg phase
    [seed_tape_machine_v2.scad]
2026-09-16 feat(v22): R-to-L order shroud tunnel + spool west, ASSET_V 10
    [seed_tape_machine_v2.scad]
2026-09-16 feat(v23): crank to back wall Y=-8, shaft back outboard, ASSET_V 11
    [seed_tape_machine_v2.scad]
2026-09-16 feat(v24): Step 3 R-to-L order proof, shroud verified printable, ASSET_V 12
    [seed_tape_machine_v2.scad]
2026-09-16 feat(v25): Step 4 tape U-bend, ASSET_V 13, 13 GLBs rebuilt
    [seed_tape_machine_v2.scad]
2026-09-16 v27 final printable pass: bearing blocks fused, shroud M3 holes, upper roller min_z=0, hopper export to base, groove wall >=1.2, ASSET_V 14
    [seed_tape_machine_v2.scad]
2026-09-17 feat(v28): tape bend true mimic of tapeubend.png, ASSET_V 15
    [seed_tape_machine_v2.scad]
2026-09-17 feat(v29): sealed drop tube bore 10/outer 14, 0.5 overlap into ribbon, ASSET_V 16
    [seed_tape_machine_v2.scad]
2026-09-17 feat(v30): fold-before-drop order fix, fold zone 67..100, ASSET_V 17
    [seed_tape_machine_v2.scad]
2026-09-17 feat(v31): fold-under-drum regression fix, forming west + transit to pipe, ASSET_V 18
    [seed_tape_machine_v2.scad]
2026-09-17 feat(v33): option B drop-tape-lower, hover pipe ID10/OD14 L10 + 10 gap, ASSET_V 20
    [seed_tape_machine_v2.scad]
2026-09-17 feat(v34): OD10 exit pipe ID6/wall2.0 L10, fold 4/R1.5 outer 7.8, ASSET_V 21
    [seed_tape_machine_v2.scad]
2026-09-17 feat(v35): thinnest-wall pipe OD10/ID7.6/wall1.2 + 45deg entry lead-ins, ASSET_V 22
    [seed_tape_machine_v2.scad]
2026-09-17 docs(req): v15 add thread wrapping + vertical pull + wind-up to MVP
2026-09-17 chore: save before v37
    [seed_tape_machine_v2.scad]
2026-09-17 docs(req): v39 6-turner + gear-only drive + cushioned pull
2026-09-17 docs(req): v40 mounting layout + 6-turner position + wind-up slip clutch
2026-09-17 chore: save before v43 gear-mesh audit
    [seed_tape_machine_v2.scad]
2026-09-17 feat(v43): true-meshed exterior gear train replaces decorative idlers, ASSET_V 27
    [seed_tape_machine_v2.scad]
2026-09-17 feat(v44): minimal drum-driven gear train, ASSET_V 28
    [seed_tape_machine_v2.scad]
2026-09-17 feat(v45): forensic tape-path + mount fix, ASSET_V 29
    [seed_tape_machine_v2.scad]
2026-09-17 feat(v45): final verify with yield-cooperative probes, drop forensic helpers
2026-09-17 docs(v45): correct collar value to final 5.0 local
    [seed_tape_machine_v2.scad]
2026-09-17 feat(v46): shaft-mounted gear train, ASSET_V 30
    [seed_tape_machine_v2.scad]
2026-09-17 feat(v47): bevel twister drive, zero exterior gears, ASSET_V 31
    [seed_tape_machine_v2.scad]
2026-09-17 feat(v48): parallel-spur + perpendicular-pinion twister drive, ASSET_V 32
    [seed_tape_machine_v2.scad]
2026-09-17 docs(v49): gradual-curl 6-folder requirements (inspiration-only STL, progressive former spec)
2026-09-17 feat(v49): gradual-curl 6-folder, 7-station loft, ASSET_V 33
    [seed_tape_machine_v2.scad]
2026-09-17 docs(v50): true 6-profile open folder requirements + scaled sample GLB
2026-09-17 docs(v51): hollow twister requirements (empty middle, 2 rod bobbin holders, side friction drive)
2026-09-17 docs(v52): smaller vertical pullers + 9.5mm nip gap requirements
2026-09-17 feat(v51): hollow twister (2 rod bobbin holders, empty middle, side friction drive), ASSET_V 34
    [seed_tape_machine_v2.scad]
2026-09-17 feat(v52): smaller d15 pullers + 9.5 nip gap + overhead twister drive, ASSET_V 36
    Carries the pending tree: vpull d20->d15 with param-driven 9.5 gap
    and 4/3 spin compensation, overhead twister drive rework, six_turner
    slot_off 1.2->1.6 (2mm open seam), viewer pivots/hooks, rebuilt GLBs.
    [seed_tape_machine_v2.scad]
2026-09-17 feat(v53): true 6-profile folder take 2 (floating tongue overlap, pipe rejected), ASSET_V 37
    [seed_tape_machine_v2.scad]
2026-09-17 docs(v54): asymmetric inner-curl 6-folder requirements (outer shell rejected, screw-mounted separate object)
2026-09-17 feat(v54): asymmetric inner-curl 6-folder, no outer shell (screw-mounted open tool); ASSET_V 38
    [seed_tape_machine_v2.scad]
2026-09-17 feat(v55): hollow 6-folder, center fin/nose/rails deleted, see-through bore; ASSET_V 38->39
    [seed_tape_machine_v2.scad]
2026-09-17 docs(v56): thin-wall tapered 6-folder matching cardboard prototype
2026-09-17 feat(v56): thin-wall tapered 6-folder (0.8 shell, cardboard-prototype match); ASSET_V 39->40
    [seed_tape_machine_v2.scad]
2026-09-17 docs(v57): hollow-loft fix, hull() filled the bore; orientation verified correct
2026-09-17 feat(v57): hollow overlapping-plate loft, no hull; bore/slit/ends open; ASSET_V 40->41
    [seed_tape_machine_v2.scad]
2026-09-17 docs(v58): big-to-small 6-turner spec (entry dia 21, exit dia 9, 1.0mm gap)
2026-09-17 feat(v58): big-to-small 6-turner (entry dia 21, exit dia 9, 1.0mm gap); ASSET_V 41->42
    [seed_tape_machine_v2.scad]
2026-09-17 feat(v59): photo-matched 6-folder adds flat entry tongue/tray per Top.jpg
    [seed_tape_machine_v2.scad]
2026-09-17 feat(v60): U-to-swirl forming plow (open-U 180 entry, hook from 21deg, watertight single solid); ASSET_V 43->44
    [seed_tape_machine_v2.scad]
2026-09-17 feat(v61): clean-sheet parametric U-to-spiral-swirl 6-folder (41 plates, spiral hook, hollow bore); ASSET_V 44->45
    [seed_tape_machine_v2.scad]
2026-09-18 feat(v62): tubular scroll 6-folder (solid block, 25.4 trench -> 8 tube + wick); ASSET_V 45->46
    [seed_tape_machine_v2.scad]
2026-09-18 feat(v63): exact spiral plow (user code verbatim, mouth 114/exit 159/axis 21); ASSET_V 46->47
    [seed_tape_machine_v2.scad]
2026-09-18 feat(v64): bare spiral plow, single watertight shell (clutter + floater deleted); ASSET_V 47->48
    [seed_tape_machine_v2.scad]
2026-09-18 feat(v65): clear tape path (blocking left tab deleted, bare sheet, flow probed); ASSET_V 48->49
    [seed_tape_machine_v2.scad]
2026-09-18 feat(v66): twister-aimed axis 13 + chassis feet/ears; down-bore align proof; ASSET_V 49->50
    [seed_tape_machine_v2.scad]
2026-09-18 feat(v69): 24:1 twister gear train implemented (Green72/layshaft/countershaft/bevel/ring+bracket); v53 removed; ASSET_V 50->51
    [seed_tape_machine_v2.scad]
2026-09-18 revert(v69): restore pre-gear CAD/viewer
    Rolls back feat(v69) 5c69b4a CAD/viewer/build outputs only.
    Restores seed_tape_machine_v2.scad, web/index.html,
    regenerate_glbs.sh, web/stl/* and .regen_cache/* to d53fee0.
    Removes v69-added tracked files (verify_v69.js, green/
    lay/countershaft/twister_ring/bracket GLBs + cache).
    Docs (PLAN_twister_gear_train, REQUIREMENTS, CHANGELOG)
    kept as historical record. v1 scad and web/backup untouched.
    [seed_tape_machine_v2.scad]
2026-09-18 docs(v70): step 1 spec — bigger drum gear 44T/roller 16T, crank 2.75x drum
2026-09-18 feat(v70): step 1 — bigger drum gear 44T/roller pinion 16T, crank 2.75x drum; ASSET_V 50->51
    [seed_tape_machine_v2.scad]
2026-09-18 docs(v71): step 2 spec — 11T M2 intermediate pinion at (155,12,60) meshing 44T drum
2026-09-18 feat(v71): step 2 — 11T M2 intermediate pinion at (155,12,60) meshing 44T drum, 4x counter-rotating; ASSET_V 51->52
    [seed_tape_machine_v2.scad]
2026-09-18 revert(step2): remove unused intermediate pinion
    [seed_tape_machine_v2.scad]
2026-09-18 docs(v72): gear twister east + drum44 chain spec (16T bevel deviation, stations, ratios)
2026-09-18 feat(v72): gear-driven orbital twister east + minimal drum44 chain
    - Move twister EAST to bind_x=186 (from 172), pull_x=210, takeup_x=242
    - Extend chassis_len 262->278 to seat shifted stations
    - Lift twister_axle_z/scroll exit for 16T ring-bevel clearance
    - 3-stage minimal chain: drum44->compound12T->shaft12T->ring16T bevel
    all in y=12 back plane; ratio (44/12)*(38/12)*(16/12)=418/27=15.4815x
    - Add intermediate_compound() (12T+38T M2, static Y pin at 156,57)
    - Add twister_drive_shaft() (Y-axis at x=bind_x, 12T spur + 12T M1.5 bevel)
    - thread_twister(): keep hollow ring bore + 2 bobbin rods, add 16T M1.5
    west-face bevel (physics-deviated from 30T brief: 30T would hang at z-7)
    - Remove v53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
    [seed_tape_machine_v2.scad]
2026-09-18 feat(v73): fix 5 visual failures in gear-driven twister
    - FIX twister ring bore: removed solid cylinder from thread_twister() union
    that was plugging the Ø18 bore; ring is now hollow (tape path clear)
    - FIX intermediate_compound double-translation: module now uses local
    coordinates instead of absolute cmp72_cx/cy/cz; eliminates misplacement
    - FIX drive_shaft double-translation: module now uses local coordinates;
    bevel pinion and spur gear now correctly positioned with teeth visible
    - FIX chassis viewing windows: added back-wall cutouts at compound and
    drive-shaft positions so interior gears are visible in assembled view
    - FIX floating gears: all gear placements now correctly connect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
    [seed_tape_machine_v2.scad]
2026-09-18 feat(v73): fix 5 visual failures in gear-driven twister
    - FIXED twister bore PLUGGED: thread_twister() now uses difference()
    with Ø18 bore cylinder through ring centre — tape passes clear
    - FIXED intermediate_compound INVISIBLE: regenerate_glbs.sh now
    has dedicated ensure_scad_for_base cases for intermediate_compound
    and drive_shaft that strip the if(part_to_render=='all') block and
    append the specific module call with min_z=0 translate
    - FIXED drive_shaft NO TEETH: same regenerate_glbs.sh fix — the
    12T M1.5 bevel pinion now exports correctly
    - FIXED gears HIDDEN inside chassis: added back/front/top wall
    viewing windows so gear chain (compound at x=156, shaft at x=186)
    is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
    [seed_tape_machine_v2.scad]
2026-09-18 docs(v74) + feat(v74): fix double-transform on compound/shaft GLBs, make visible, bump ASSET_V
2026-09-18 docs(v75) + feat(v75): fix compound/shaft viewer coords, twister ratio, bump ASSET_V
    - Fix compound viewer pos: SCAD (156,12,57) -> viewer (156,57,-12), rot [0,0,0]
    - Fix drive_shaft viewer pos: SCAD (186,12,17) -> viewer (186,17,-12), rot [-PI/2,0,0]
    - Fix twister ratio: multiply by DRUM_RATIO (16/44) so ring speed = 15.48x drum
    - Bump ASSET_V 55 -> 56 for bevel-tooth twister GLB cache bust
2026-09-19 docs(v76): fix compound/shaft viewer coords, pivots, rotation, ASSET_V
2026-09-19 feat(v76): add compound/shaft pivots, rotation animation, bevel teeth verified
2026-09-19 feat(v77): fix double-transform on compound, wire animation, fix rotation axes
2026-09-19 docs(v78) + feat(v78): compound pivot y-fix, twister bevel Y-rot, intermediate_compound regen
    - FIX: compoundPivot.position.y 30->57 to match SCAD z=57
    - FIX: thread_twister() bevel rotate([90,0,0])->rotate([0,90,0])
    - FIX: regenerate intermediate_compound.glb (12T+38T, ~80mm OD)
    - Bump ASSET_V 58->59
    [seed_tape_machine_v2.scad]
2026-09-19 revert(v79): remove twister gear train (v72-v78), restore pre-twister state
    [seed_tape_machine_v2.scad]
2026-09-19 docs(v72): twister redesign — ring Ø18, bevel 28T/12T M1.5, bracket flat-base, twister_lift=23
2026-09-19 feat(v72): twister ring Ø18 + bevel teeth + bracket + twister_lift=23
    [seed_tape_machine_v2.scad]
2026-09-19 feat(v72): lift 21 + pinion GLB
    [seed_tape_machine_v2.scad]
2026-09-19 fix: remove internal translate from twister_pinion() to eliminate double-transform
    The module baked translate([bind_x, chassis_width/2, twister_axle_z])
    inside twister_pinion(), but assembly L2443 also places it at the same
    station and export adds lift — causing the pinion to land ~179mm off.
    Delete the internal translate so the module is origin-centred; the
    assembly handles placement.
    [seed_tape_machine_v2.scad]
2026-09-19 fix: twister bore_dia=19 for Ø18 clearance, freeze twister_bracket
    [seed_tape_machine_v2.scad]
2026-09-19 v74: split twister_bracket from twister.glb, fix twister_pinion pos, bump ASSET_V
    - twister_bracket: standalone part_to_render export, origin-centred min_z=0
    - twister.glb: removed bracket geometry, now ring+bevel+eyelets+bobbins only
    - twister_pinion PART_DEF: pos [0,0,0] -> [0,-21,0] for mirror lift compensation
    - ASSET_V 53->54
    - regenerate_glbs.sh: added twister_bracket to ALL_GLB
    [seed_tape_machine_v2.scad]
2026-09-19 v75: docs - gear-driven chain spec, chassis/twister changes
2026-09-19 v75: CAD - gear-driven chain (5-stage spur M1.5 + bevel), ring r18.5/OD53, crown 16T, bobbins 90° orbit 18, pull_x 196, chassis 64x278
    [seed_tape_machine_v2.scad]
2026-09-20 v75: crown+pinion mesh visible, gear train wired with per-shaft pivots, ring ratio 17.2032@173, remove stale gear_train, fix pinion support
    [seed_tape_machine_v2.scad]
2026-09-20 v75: docs - final records: chain ratio 17.2032x (4x1.6^3x1.4x0.75), gear train on back conduit z=32, orbit 16.25, crown full-height teeth fix, viewer per-shaft pivots
2026-09-20 chore: commit before editing requirements
    [6 folder.stl, parametric_box.scad, phone_stand.scad]
2026-09-20 revert(v76): restore v57 plow + v53 gear drive, discard v3 artifacts
    [6 folder.stl, seed_tape_machine_v2.scad]
2026-09-20 chore: untrack root photos, previews, duplicate stls
    [cartridge.stl, chassis.stl, cones.stl, crank.stl, hopper.stl, plow.stl, rollers.stl, shroud.stl]
2026-09-20 docs: forbid .stl intermediates in version preview folders
2026-09-20 chore: snapshot web files into web/v53-v73 on version advance
    [cartridge.stl, chassis.stl, cones.stl, crank.stl, hopper.stl, plow.stl, rollers.stl]
2026-09-20 v79: crank 20T meshes drum 40T at x=160, drum gear front plane, rollers removed, shroud east (116-124)
    - SCAD: crank_axle_x=160, shroud_x0=116/x1=124, drum gear +gear_off (front),
    pull_rollers() simplified, crank at x=160 in animated_assembly
    - Viewer: crankMount 160, shroudPivot 116, lower/upper pivots removed,
    _setRotations + animation loop updated, ASSET_V 43
    - 5 GLBs regenerated (chassis, hopper, shroud, cartridge, crank)
    - Stale roller GLBs deleted (rollers_lower, rollers_upper, rollers)
    - verify_v79.js: 3 pivots ±0.15mm, 3 ratios ±3% signs, ASSET_V=43, 0 errors
    - web/v79/ snapshot created
    [seed_tape_machine_v2.scad]
2026-09-21 requirements: v80 Step A (exact v66 plow restore) + delivery flow
2026-09-21 v80 Step A: restore exact v66/67/68 plow (scroll_sheet six_turner) + web/v80 snapshot
    [seed_tape_machine_v2.scad]
2026-09-21 requirements: v81 Step B (crank 20T + drum gear back-plane + counter-rotation)
2026-09-21 requirements: v81 Step B amended (both gears front, short crank shaft)
2026-09-21 requirements: v81 Step B amended (both gears front, short crank shaft)
    Also: AGENTS.md docs-routing section (docs tasks -> general, not scribe).
2026-09-21 v81: both gears front-plane (crank 20T + drum 40T external mesh, counter-rotation) + web/v81 snapshot
    [seed_tape_machine_v2.scad]
2026-09-21 fix: cartridge export gear offset +13.9mm (v81 mesh follow-up)
    [seed_tape_machine_v2.scad]
2026-09-21 fix: drum gear mesh phase (teeth in gaps) + export offset proof, ASSET_V 45
    [seed_tape_machine_v2.scad]
2026-09-21 feat(v82): modular SCAD split, behavior-preserving
    Master seed_tape_machine_v2.scad 2407→181 lines + 6 scad/ part files. Overhead-drive labels renamed to plain words. 17/17 STL hashes identical, 14/14 GLBs identical, reviewer visual PASS (0 console errors, animation + tape-static OK).
    [chassis.scad, feed.scad, gears.scad, params.scad, plow.scad, seed_tape_machine_v2.scad, stations.scad]
2026-09-21 feat(v83): twister redesign — hollow axle + Class-15 flyer
    R19 orbit, chassis 60→68 lane 34, hollow axle Ø10/OD15 with snap fingers, r23 flyer disc + 2 Class-15 bobbins + eyelets, base slot + feet, overhead drive removed, crank/drum mesh preserved, reviewer visual PASS.
    [chassis.scad, params.scad, plow.scad, seed_tape_machine_v2.scad, stations.scad]
2026-09-21 docs: approval gate — commit only after user sign-off
2026-09-22 docs(v85): twister clean-sheet rebuild spec — pins/teeth/mouth/axis-fix
2026-09-22 docs(v86): axle mouth solid + true bevel teeth spec
2026-09-22 docs(v87): rotor teeth revert to v85 wedge profile spec
2026-09-22 docs(v93): 15mm lift off base spec + changelog
2026-09-22 feat(v92): scad refactor + viewer + GLB regen + verify scripts
    [feed.scad, params.scad, seed_tape_machine_v2.scad, stations.scad]
2026-09-22 fix(v93): plow ground clearance + twister bore alignment in viewer
    Plow exit bore back to base-fused zero clearance (pivot Y 19->4;
    +15 lift lives in geometry, axis_z=28); twister rotor reseated
    coaxial with axle bore (pivot Y 14.5->32). Exit 32 = twister 32.
    CAD unchanged (asserts already enforce); no GLB regen, ASSET_V 56.
    verify_v88 PASSED, 0 console errors. CHANGELOG v93 + web/v93 snapshot.
    [chassis.scad, feed.scad, params.scad, plow.scad, seed_tape_machine_v2.scad, stations.scad]
2026-09-22 chore(git): untrack web/v* preview snapshots + gitignore
    Snapshots stay local-only reference; .gitignore gains web/v*/.
    [cartridge.stl, chassis.stl, cones.stl, crank.stl, hopper.stl, plow.stl, rollers.stl]
2026-09-22 feat(v95): from-crank twister drive 2.5 wraps/seed + print set
    Crank up to (152,104.93) on r60 mesh circle; new train crank20 ->
    A[10+30] -> B[10+bevel] -> C[bevel+15] -> idler[12+12] -> D[12+wheel]
    -> friction tire on disc OD (2x3x1x1.25 = 7.5x/crank). Fused
    clusters, wall-to-wall rail, chassis pedestal, ~60 fail-loud
    asserts, 7 new GLBs + toggles + spins, print/ (25 STLs), ASSET_V 57.
    [bar1.stl, cartridge.stl, chassis.scad, chassis.stl, cone_a.stl, cone_b.stl, cones.stl, crank.stl]
2026-09-23 feat(v101): standard bevel teeth + close-coupled B composite; hopper smooth-taper rebuild
    [bar1.stl, chassis.scad, chassis.stl, drive_train.scad, feed.scad, gear_B.stl, gear_C.stl, gear_D.stl]
2026-09-23 feat(v111): crank through-shaft + outboard A30/B10 mesh + support wall + bevel slim + mesh fixes
    [chassis.stl, cone_a.stl, cone_b.stl, cones.stl, crank.stl, drive_train.scad, gear_A.stl, gear_B.stl]
2026-09-23 feat(v112-v117): twister bevel ring + B mitre mate + idler drive + wall support + stub cuts
    [chassis.scad, chassis.stl, drive_train.scad, gear_A.stl, gear_B.stl, gear_I.stl, gearwall.stl, params.scad]
2026-09-23 feat(v118-v121): snap-fit axle nose + rotation fix + axial retention + remove cones
2026-09-23 feat(v122-v123): axle nose manifold rebuild + mesh audit pass
    [stations.scad, twister_axle.stl]
2026-09-23 feat(v124-v125): checkpoint hopper tape and support work
    [chassis.scad, chassis.stl, drive_train.scad, feed.scad, gear_A.stl, gear_B.stl, hopper.stl, params.scad]
2026-09-24 feat(v126): fresh step13 axle and gear train
    [chassis.scad, chassis.stl, drive_train.scad, feed.scad, gearwall.stl, params.scad, plow.scad, seed_tape_machine_v2.scad]
2026-09-24 docs(v127): step-wise workflow + project skills into repo
    - AGENTS.md: mandatory step-wise CAD workflow (ordered queue, continuous chain, rollback+redo, purge, 3-angle review, isolation, printability gates)
    - Skills load receipt requires code-philosophy + openscad + openscad-iterative-modeling for step work
    - Track skills/, .agents/, .opencode/skills/openscad-iterative-modeling/, skills-lock.json
    - CHANGELOG v127 entry; local snapshot web/v127 (not committed)
    [parametric_box.scad, phone_stand.scad]
2026-09-24 docs(v128): per-step validation before preview in step-wise workflow
    - Step done = implementation → per-step final validation → preview
    - Full gate every step (asserts, printability, watertight, min gap, visual)
    - Track .agents/skills/openscad/
    - Local snapshot web/v128 (not committed)
    [parametric_box.scad, phone_stand.scad]
2026-09-24 feat(v130): checkpoint chassis and twister refinements
    [chassis.scad, chassis.stl, drive_train.scad, gear_B.stl, params.scad, plow.scad, plow.stl, pull_a.stl]
2026-09-24 fix(v131): seat twister axle farther east
    [chassis.scad, chassis.stl, params.scad, stations.scad]
2026-09-25 docs(AGENTS): step isolation + per-step report, skill-load fallback paths, layman/Telugu comms rule
    - Steps are isolated units; report each step as it finishes (no end-of-queue batch)
    - SCAD work loads code-philosophy + openscad + openscad-iterative-modeling together
    - 'Skill not found' -> read SKILL.md from known paths; never ask for .opencode access
    - New Communication section: ask user in layman terms or Telugu (no 3D/gear jargon)
2026-09-25 feat(v132): add supports and remove take-up funnel
    [chassis.scad, drive_train.scad, params.scad, plow.scad, stations.scad]
2026-09-26 feat(v133-v136): chassis, take-up, U guide, rolling tape packet, ASSET_V 96->100
    Four steps of the seed-taper rework, validated together.
    Step 3 (v133): chassis lengthened 30mm east; whole east edge moves with it.
    Step 4 (v134): take-up station moved to CAD (274,50), leaving an exact 10mm
    east-edge margin; leader endpoint re-derived from the new pack centre;
    rotation stays -2x crank.
    Step 5 (v135): separate printed U guide on the hopper, one right bracket
    printed twice and mirrored, two M2x8 per bracket, two hopper bosses. The
    M2 joint is real: pad, counterbored head, hex nut trap, >= 1.0mm material
    around the flats.
    Step 6 (v136): the seed tape's U-bend moved out from under the r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
    [chassis.stl, feed.scad, hopper.stl, params.scad, plow.scad, plow.stl, seed_tape_machine_v2.scad, south_wall.stl]
2026-09-26 fix(v137): rebuild stale print/gearwall.stl and print/twister_axle.stl
    Both committed print STLs predated the code they are generated from. They were
    last exported at v126 and v130, while scad/stations.scad and scad/params.scad
    were edited at v131 ("seat twister axle farther east") and v132 without
    re-exporting. Measured:
    gearwall vol 18960.0 -> 22310.6 (+17.7%), X max 222 -> 234, Z 14 -> 13
    twister_axle vol 4349.8 -> 5131.2 (+18.0%), 1 body -> 2, Y 22..46 -> 3..43
    The Y shift is exactly the 19mm the v131 commit message describes.
    Only the two .stl files changed. The matching web/stl/*.glb were already
    correct and are byte-identical after the rebuild, so the three.js viewer wa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
    [gearwall.stl, twister_axle.stl]
2026-09-26 chore(v138): verify print STL vs viewer GLB agreement on every run
    Tooling only, no geometry, no ASSET bump. Closes the v137 staleness class.
    Both files are written from ONE export, so within a run they cannot disagree.
    A disagreement on disk means one of the two was restored, copied, or committed
    from a different export - which is exactly how print/gearwall.stl and
    print/twister_axle.stl sat ~18% wrong for several versions while the previews
    looked correct.
    cross_check() re-loads each part's print/<part>.stl and web/stl/<part>.glb
    from disk and compares volume, area, and the three SORTED side lengths (sorted
    because the print copy is rigidly rotated by print_rot and dropped to min_z=0,
    so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
2026-09-26 feat(v140-v144): gear phases, top-fitted plow screws, open twister bore, ASSET_V 101->104
    Gear train (v141): every remaining gear starting angle aligned by measurement,
    teeth only, via a new spur_gear(tooth_phase=) that leaves bores and hubs at
    phase 0. Drum and crank untouched - the drum mesh admits no other rigid phase
    and is the datum. Drum/crank and crank/A10 pairs unchanged; A30<->idler
    16.33 -> 0.11 mm3 and idler<->B10 32.20 -> 0.02 mm3. Gear volumes bit-identical
    to HEAD (delta 0.000000), so no printed gear changed size. Also fixed a v140
    double count in the viewer, where the A10's baked +6 was applied twice, and the
    idler had no phase in the preview at all.
    Plow (v142-v143): the lon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
    [chassis.scad, chassis.stl, drive_train.scad, gear_A.stl, gear_B.stl, gear_I.stl, gears.scad, params.scad]
